emorell96/WaterSystemLock/RTD Measurement/Simulations by TI/Readme.txt

Resistance Temperature Detector RTD Linearization

RTD Linearization v7.xls
This Excel file calculates platinum RTD resistance and circuit values to linearize output voltage over a specified temperature range. Two solutions are shown—one using an op amp, the other using an instrumentation amplifier.

Entry values are highlighted in yellow. Results are in green.

Excel 2003 was used and the worksheet uses only basic math functions. The graph shows nonlinearity of the RTD and nonlinearity of the corrected voltage output, assuming perfect amplifiers and exact resistor values.

RTD Linearization, Op Amp circuit.TSC
Tina SPICE simulation file for the op amp-based RTD linearization circuit. This file can be run with the free version of Tina-TI, downloadable at www.ti.com/tina-ti.

RTD Linearization, Inst Amp circuit.TSC
Tina SPICE simulation file for the instrumentation amplifier-based linearization circuit. This file can be run with the free version of Tina-TI, downloadable at www.ti.com/tina-ti.

ALL CONTENT AND MATERIALS IN THESE FILES ARE PROVIDED "AS IS". TI AND ITS RESPECTIVE SUPPLIERS AND PROVIDERS OF CONTENT MAKE NO REPRESENTATIONS ABOUT THE SUITABILITY OF THESE MATERIALS FOR ANY PURPOSE AND DISCLAIM ALL WARRANTIES AND CONDITIONS WITH REGARD TO THESE MATERIALS, INCLUDING BUT NOT LIMITED TO ALL IMPLIED WARRANTIES AND CONDITIONS OF MERCHANTABILITY, FITNESS FOR A PARTICULAR PURPOSE, TITLE AND NON-INFRINGEMENT OF ANY THIRD PARTY INTELLECTUAL PROPERTY RIGHT. TI AND ITS RESPECTIVE SUPPLIERS AND PROVIDERS OF CONTENT MAKE NO REPRESENTATIONS ABOUT THE SUITABILITY OF THESE MATERIALS FOR ANY PURPOSE AND DISCLAIM ALL WARRANTIES AND CONDITIONS WITH RESPECT TO THESE MATERIALS. NO LICENSE, EITHER EXPRESS OR IMPLIED, BY ESTOPPEL OR OTHERWISE, IS GRANTED BY TI. USE OF THE INFORMATION ON THIS SITE MAY REQUIRE A LICENSE FROM A THIRD PARTY, OR A LICENSE FROM TI.
