emorell96/WaterSystemLock/UHV Gate Valve Control/Project Outputs for Free Documents/BOM/Bill of Materials-UHV Gate Valve Control.xlsx

Line # | Name | Description | Designator | Quantity | Adjusted Quantity | Manufacturer 1 | Manufacturer Part Number 1 | Manufacturer Lifecycle 1 | Supplier 1 | Supplier Part Number 1 | Supplier Unit Price 1 | Supplier Subtotal 1
 | 22uF | CAP ALUM 22UF 20% 100V RADIAL | C6 | 1 | 3 | Panasonic | EEUFC2A220 | Volume Production | Digi-Key | P10770-ND | 0.46 | 2.3
 | 0.1uF | CAP CER 0.1UF 25V X7R 0805 | C1, C2, C4, C11, C12, C13, C14, C15, C16, C17, C20 | 11 | 28 | Samsung | CL21B104KACNNNC | Volume Production | Digi-Key | 1276-1099-6-ND | 0.0203 | 2.03
 | 2.2uF | CAP CER 2.2UF 100V X7R 1206 | C9 | 1 | 3 | KEMET | C1206C225K3RACTU | Volume Production | Digi-Key | 399-8180-1-ND | 0.35 | 1.75
 | 4.7uF | CAP CER 4.7UF 10V X7R 1206 | C10 | 1 | 3 | Samsung | CL31B475KPHNNNE | Volume Production | Digi-Key | 1276-1133-1-ND | 0.28 | 1.4
 | 4.7uF | CAP CER 4.7UF 50V X5R 1206 | C7, C8 | 2 | 5 | TDK | C3216X5R1H475K085AB | Volume Production | Digi-Key | 445-14692-6-ND | 0.664 | 6.64
 | 10uF | CAP CER 10UF 25V X7R 1206 | C18, C19 | 2 | 5 | KEMET | C1206C106M3RACTU | Volume Production | Digi-Key | 399-7443-1-ND | 0.548 | 5.48
 | 22uF | CAP CER 22UF 25V X5R 1206 | C21, C22 | 2 | 5 | Samsung | CL31A226KAHNNNE | Volume Production | Digi-Key | 1276-3047-6-ND | 0.361 | 3.61
 | 10000pF | CAP CER 10000PF 25V X7R 0805 | C3, C5 | 2 | 5 | Samsung | CL21B103KAANNNC | Volume Production | Digi-Key | 1276-2434-6-ND | 0.054 | 0.54
 | 22272021 | CONN HEADER 2POS .100 VERT TIN | RLY_F | 1 | 3 | Molex | 22-27-2021 | Volume Production | Newark | 74C1122 | 0.122 | 0.61
 | 22272031 | CONN HEADER 3POS .100 VERT TIN | J2 | 1 | 3 | Molex | 22-27-2031 | Volume Production | Digi-Key | WM4112-ND | 0.37 | 1.85
 | 691508110303 | CONN TERM BLK 3POS 3.5MM BLACK | AC_POW_IN, AC_POW_OUT | 2 | 5 | Wurth Electronics | 691508110303 | Volume Production | Digi-Key | 732-5964-1-ND | 3.4 | 33.95
 | NXJ1S0505MC-R7 | DC/DC SM 1W 5V-5V SINGLE 4.2KV | A1 | 1 | 3 | Murata | NXJ1S0505MC-R7 | Volume Production | Digi-Key | 811-3094-6-ND | 3.53 | 17.65
 | SI8641BB-B-IS | DGTL ISO 2.5KV GEN PURP 16SOIC | IC2 | 1 | 3 | Silicon Labs | Si8641BB-B-IS | Volume Production | Digi-Key | SI8641BB-B-IS-ND | 1.84 | 9.2
 | ADA4075-2ARZ | Double Channel Ultra Low Noise Operational Amplifier, 6.5 MHz BW, 12 V/us SR, Industrial, 8-pin SOIC (R-8), Tube | U5 | 1 | 3 | Analog Devices | ADA4075-2ARZ | Volume Production | Digi-Key | ADA4075-2ARZ-ND | 2.27 | 11.35
 | 3.3uH | FIXED IND 3.3UH 9A 9 MOHM SMD | L3 | 1 | 3 | Wurth Electronics | 744314330 | Volume Production | Digi-Key | 732-1160-1-ND | 3.56 | 17.8
 | VLCF4024T-4R7N1R4-2 | FIXED IND 4.7UH 1.43A 87 MOHM | L1 | 1 | 3 | TDK EPCOS | VLCF4024T-4R7N1R4-2 | Volume Production | Digi-Key | 445-8737-1-ND | 0.97 | 4.85
 | VLCF4024T-100MR90-2 | FIXED IND 10UH 900MA 136 MOHM | L2 | 1 | 3 | TDK | VLCF4024T-100MR90-2 | Volume Production | Digi-Key | 445-8727-6-ND | 0.97 | 4.85
 | 3-1415055-1 | Force Guided Relay SR4 D/M, 24 V, 8 A, -25 to 70 degC, 10-Pin THD, RoHS, Box and Tube | K1 | 1 | 3 | TE Connectivity Schrack | 3-1415055-1 | Volume Production | Digi-Key | PB661-ND | 22.98 | 114.9
 | CD74HC21M96 | High Speed CMOS Logic Dual 4-Input AND Gates, D0014A, LARGE T&R | U3 | 1 | 3 | Texas Instruments | CD74HC21M96 | Volume Production | Digi-Key | 296-31574-6-ND | 0.54 | 2.7
 | TPS563201DDCT | IC REG BUCK ADJ 3A SYNC | IC4 | 1 | 3 | Texas Instruments | TPS563201DDCT | Volume Production | Digi-Key | 296-43393-6-ND | 0.93 | 4.65
 | BSS138WH6327XTSA1 | MOSFET N-CH 60V 280MA SOT-323 | IC1, IC3 | 2 | 5 | Infineon | BSS138W | Unknown | Digi-Key | BSS138WH6327XTSA1DKR-ND | 0.25 | 2.5
 | NE555D | Precision Timer, 4.5 to 16 V, 0 to 70 degC, 8-Pin SOIC (D), Green (RoHS & no Sb/Br), Tube | U2 | 1 | 3 | Texas Instruments | NE555D | Volume Production | Digi-Key | 296-16792-ND | 0.41 | 2.05
 | 1k | RES SMD 1K OHM 1% 1/4W 1206 | R1 | 1 | 3 | Panasonic | ERJ-8ENF1001V | Volume Production | Digi-Key | P1.00KFCT-ND | 0.1 | 0.5
 | 10k | RES SMD 10K OHM 1% 1/2W 0805 | R12, R13 | 2 | 5 | Panasonic | ERJ-P06F1002V | Volume Production | Digi-Key | P16059DKR-ND | 0.148 | 1.48
 | 10k | RES SMD 10K OHM 1% 1/4W 1206 | R4, R5, R6, R8, R15 | 5 | 13 | Panasonic | ERJ-8ENF1002V | Volume Production | Digi-Key | P10.0KFCT-ND | 0.089 | 2.23
 | 54.9k | RES SMD 54.9K OHM 0.5% 1/2W 0805 | R11 | 1 | 3 | Panasonic | ERJ-P06D5492V | Volume Production | Digi-Key | P16052DKR-ND | 0.31 | 1.55
 | 510k | RES SMD 510K OHM 5% 1/4W 1206 | R3 | 1 | 3 | Panasonic | ERJ-8GEYJ514V | Volume Production | Digi-Key | P510KEDKR-ND | 0.1 | 0.5
 | 620 | RES SMD 620 OHM 1% 1/4W 1206 | R7, R9, R10, R14 | 4 | 10 | Panasonic | ERJ-8ENF6200V | Volume Production | Digi-Key | P620FDKR-ND | 0.089 | 1.78
 | SN74LVC1G86DBVR | Single 2-Input Exclusive-OR Gate, DBV0005A, LARGE T&R | U4 | 1 | 3 | Texas Instruments | SN74LVC1G86DBVR | Volume Production | Digi-Key | 296-9853-1-ND | 0.33 | 1.65
 | LM311DR2G | Single Comparator, 5 to 30 V, 0 to 70 degC, 8-Pin SOIC, Pb-Free, Tape and Reel | U1 | 1 | 3 | ON Semiconductor | LM311DR2G | Volume Production | Digi-Key | LM311DR2GOSDKR-ND | 0.43 | 2.15
 | AB11AH-HC | SWITCH PUSH SPST-NO 0.4VA 28V | RST | 1 | 3 | NKK Switches | AB11AH-HC | Volume Production | Digi-Key | 360-2604-ND | 5.5 | 27.5
 | CL-SB-12B-01T | SWITCH SLIDE SPDT 200MA 12V | BYP, INT_SWITCH, ON, SW5V | 4 | 10 | Nidec Copal | CL-SB-12B-01T | Volume Production | Digi-Key | 563-1318-1-ND | 0.924 | 18.48
 | 282834-2 | TERM BLOCK 2POS SIDE ENT 2.54MM | EXT_SWITCH, J1, POW5, POW12 | 4 | 10 | TE Connectivity | 282834-2 | Volume Production | Digi-Key | A98333-ND | 0.626 | 12.52
 | 20k | TRIMMER 20K OHM 3/8" CERMET TH | R2 | 1 | 3 | TT BI | 91AR20KLF | Volume Production | Digi-Key | 987-1170-ND | 1.5 | 7.5
 | SM15T15CA | TVS DIODE 12.8VWM 27.2VC SMC | D1 | 1 | 3 | STMicroelectronics | SM15T15CA | Volume Production | Digi-Key | 497-7863-1-ND | 0.87 | 4.35
 | LED2 | Typical RED GaAs LED | FAIL | 1 | 3
 | LED1 | Typical RED GaAs LED | RLOK1, RLOK2 | 2 | 5
 | 696105003002 | WR-FSH Fuse Holder Blocks Fuse Holder Blocks Clip Cover for PCB | XF1 | 1 | 3 | Wurth Electronics | 696105003002 | Unknown | Digi-Key | 732-11373-ND | 0.64 | 3.2
