emorell96/WaterSystemLock/RTD Measurement/Project Outputs for Free Documents/BOM/Bill of Materials-RTDMeasurement.xls

Line # | Name | Description | Designator | Quantity | Manufacturer 1 | Manufacturer Part Number 1 | Manufacturer Lifecycle 1 | Supplier 1 | Supplier Part Number 1 | Supplier Unit Price 1 | Supplier Subtotal 1
 | NXJ1S0505MC-R7 | DC/DC SM 1W 5V-5V SINGLE 4.2KV | A1 | 1 | Murata | NXJ1S0505MC-R7 | Volume Production | Digi-Key | 811-3094-1-ND | 3.55 | 3.55
 | 0.10uF | CAP CER 0.1UF 16V X7R 0402 | C1A, C1B, C1C, C1D, C1E, C1F, C1G, C1H, C1I, C1J, C1K, C1L, C2A, C2B, C2C, C2D, C2E, C2F, C2G, C2H, C2I, C2J, C2K, C2L, C6A, C6B, C6C, C6D, C6E, C6F, C6G, C6H, C6I, C6J, C6K, C6L, C15A, C15B, C15C, C16A, C16B, C16C, C17A, C17B, C17C, C18A, C18B, C18C, C19A, C19B, C19C, C20A, C20B, C20C, C37 | 55 | Murata | GRM155R71C104JA88D | Volume Production | Mouser | 81-GRM155R71C104JA8D | 0.018 | 1.8
 | 1uF | CAP CER 1UF 25V X7R 0805 | C3A, C3B, C3C, C4A, C4B, C4C, C5A, C5B, C5C | 9 | KEMET | C0805C105J3RACTU | Volume Production | Digi-Key | 399-10060-2-ND | 0.32905 | 822.63
 | 22uF | CAP ALUM 22UF 20% 100V RADIAL | C7, C21, C29 | 3 | Panasonic | EEUFC2A220 | Volume Production | Digi-Key | P10770-ND | 0.46 | 1.38
 | 4.7uF | CAP CER 4.7UF 50V X5R 1206 | C8, C9, C22, C23, C30, C31 | 6 | TDK | C3216X5R1H475K085AB | Volume Production | Digi-Key | 445-14692-2-ND | 0.231 | 924
 | 22uF | CAP CER 22UF 25V X5R 1210 | C10, C11, C12, C13, C25, C26, C27, C28, C33, C34, C35, C36 | 12 | Murata | GRM32ER61E226KE15K | Volume Production | Digi-Key | 490-6540-2-ND | 0.6537 | 2614.8
 | 0.022uF | CAP CER 0.022UF 100V X7R 0805 | C14 | 1 | KEMET | C0805S223K1RACTU | Volume Production | Digi-Key | 399-13176-2-ND | 0.10061 | 402.44
 | 2.2uF | CAP CER 2.2UF 100V X7R 1206 | C24, C32, C43 | 3 | Samsung | CL31B225KCHSNNE | Volume Production | Digi-Key | 1276-3138-2-ND | 0.22539 | 450.78
 | 10uF | CAP CER 10UF 25V X7R 1206 | C38, C39 | 2 | KEMET | C1206C106M3RACTU | Volume Production | Digi-Key | 399-7443-2-ND | 0.19808 | 396.16
 | 0.1uF | CAP CER 0.1UF 25V X7R 0805 | C40 | 1 | KEMET | C0805C104J3RACTU | Volume Production | Digi-Key | 399-7997-2-ND | 0.1485 | 594
 | 22uF | CAP CER 22UF 10V X7R 1206 | C41, C42 | 2 | KEMET | C1206C226M8RACTU | Volume Production | Digi-Key | 399-7444-2-ND | 0.17055 | 341.1
 | 4.7uF | CAP CER 4.7UF 10V X7R 1206 | C44 | 1 | Samsung | CL31B475KPHNNNE | Volume Production | Digi-Key | 1276-1133-2-ND | 0.0506 | 101.2
 | 22272081 | CONN HEADER 8POS .100 VERT TIN | CF1A, CF1B, CF1C, CF2A, CF2B, CF2C, J2, J3 | 8 | Molex | 22272081 | Unknown | Digi-Key | WM4117-ND | 0.6 | 4.8
 | SI8640BD-B-IS | DGTL ISO 5KV 4CH GEN PURP 16SOIC | IC1A, IC1B, IC1C, IC2A, IC2B, IC2C, IC3A, IC3B, IC3C | 9 | Silicon Labs | SI8640BD-B-IS | Volume Production | Digi-Key | 336-2083-5-ND | 3.59 | 32.31
 | BSS138WH6327XTSA1 | MOSFET N-CH 60V 280MA SOT-323 | IC4 | 1 | Infineon | BSS138WH6327XTSA1 | Volume Production | Digi-Key | BSS138WH6327XTSA1DKR-ND | 0.35 | 0.35
 | TPS563201DDCT | IC REG BUCK ADJ 3A SYNC | IC5 | 1 | Texas Instruments | TPS563201DDCT | Volume Production | Digi-Key | 296-43393-2-ND | 0.60844 | 152.11
 | SJ-3506-SMT-TR | Female Mid Mount Audio Jack, 6 Position, Height 2.55 mm, Tail Length 2 mm, -25 to 85 degC, RoHS, Tape and Reel | J1A, J1B, J1C, J1D, J1E, J1F, J1G, J1H, J1I, J1J, J1K, J1L | 12 | CUI | SJ-3506-SMT-TR | Volume Production | Digi-Key | CP-3506SJCT-ND | 1.65 | 19.82
 | SDS-50J | CONN RCPT FMALE DIN 5POS SOLDER | J4 | 1 | CUI | SDS-50J | Volume Production | Digi-Key | CP-2350-ND | 1.86 | 1.86
 | PJ-063AH | Through Hole Right Angle DC Power Jack, 8 A, 2 mm Center Pin, 2 Position, -25 to 85 degC, RoHS, Bulk | J5 | 1 | CUI | PJ-063AH | Volume Production | Digi-Key | CP-063AH-ND | 1.36 | 1.36
 | 3.3uH | FIXED IND 3.3UH 9A 9 MOHM SMD | L1 | 1 | Wurth Electronics | 744314330 | Volume Production | Digi-Key | 732-1160-2-ND | 2.55 | 2554.01
 | VLCF4024T-4R7N1R4-2 | FIXED IND 4.7UH 1.43A 87 MOHM | L2 | 1 | TDK EPCOS | VLCF4024T-4R7N1R4-2 | Volume Production | Digi-Key | 445-8737-2-ND | 0.441 | 220.5
 | VLCF4024T-100MR90-2 | FIXED IND 10UH 900MA 136 MOHM | L3 | 1 | TDK | VLCF4024T-100MR90-2 | Volume Production | Digi-Key | 445-8727-2-ND | 0.441 | 220.5
 | CL-SB-12B-01T | SWITCH SLIDE SPDT 200MA 12V | ON/OFF1, ON/OFF_+5 | 2 | Nidec Copal | CL-SB-12B-01T | Volume Production | Digi-Key | 563-1318-1-ND | 0.9 | 1.8
 | 691321100003 | Serie 3211 - 3.50mm Vertical PCB Header WR-TBL, 3 pin | POW_1, POW_2 | 2 | Wurth Electronics | 691321100003 | Volume Production | Digi-Key | 732-2764-ND | 0.69 | 1.38
 | 4.99k | RES SMD 4.99K OHM 0.1% 1/8W 0805 | R1A, R1B, R1C, R1D, R1E, R1F, R1G, R1H, R1I, R1J, R1K, R1L, R2A, R2B, R2C, R2D, R2E, R2F, R2G, R2H, R2I, R2J, R2K, R2L | 24 | Panasonic | ERA-6AEB4991V | Volume Production | Digi-Key | P4.99KDATR-ND | 0.03749 | 187.45
 | 118 | RES SMD 118 OHM 0.1% 1/8W 0805 | R3A, R3B, R3C, R3D, R3E, R3F, R3G, R3H, R3I, R3J, R3K, R3L | 12 | Panasonic | ERA-6AEB1180V | Unknown | Digi-Key | P118DATR-ND | 0.04158 | 207.9
 | 107 | RES SMD 107 OHM 0.1% 1/8W 0805 | R4A, R4B, R4C, R4D, R4E, R4F, R4G, R4H, R4I, R4J, R4K, R4L | 12 | Panasonic | ERA6AEB1070V | Not Recommended for New Design | Digi-Key | P107DACT-ND | 0.302 | 3.62
 | 10.2k | RES SMD 10.2K OHM 0.1% 1/8W 0805 | R5A, R5B, R5C, R5D, R5E, R5F, R5G, R5H, R5I, R5J, R5K, R5L | 12 | Panasonic | ERA6AEB1022V | Not Recommended for New Design | Digi-Key | P10.2KDADKR-ND | 0.302 | 3.62
 | 15.8k | RES SMD 15.8K OHM 1% 1/8W 0805 | R6A, R6B, R6C, R6D, R6E, R6F, R6G, R6H, R6I, R6J, R6K, R6L, R7A, R7B, R7C, R7D, R7E, R7F, R7G, R7H, R7I, R7J, R7K, R7L, R14, R15 | 26 | Panasonic | ERJ-6ENF1582V | Volume Production | Digi-Key | P15.8KCTR-ND | 0.00961 | 48.05
 | 1k | RES SMD 1K OHM 1% 1/4W 1206 | R8A, R8B, R8C, R8D, R8E, R8F, R8G, R8H, R8I, R8J, R8K, R8L | 12 | Panasonic | ERJ-8ENF1001V | Volume Production | Digi-Key | P1.00KFTR-ND | 0.01191 | 59.55
 | 20k | TRIMMER 20K OHM 3/8" CERMET TH | R9A, R9B, R9C, R9D, R9E, R9F, R9G, R9H, R9I, R9J, R9K, R9L | 12 | TT BI | 91AR20KLF | Volume Production | Digi-Key | 987-1170-ND | 1.32 | 15.84
 | 510k | RES SMD 510K OHM 5% 1/4W 1206 | R10A, R10B, R10C, R10D, R10E, R10F, R10G, R10H, R10I, R10J, R10K, R10L | 12 | Panasonic | ERJ-8GEYJ514V | Volume Production | Digi-Key | P510KETR-ND | 0.0088 | 44
 | 0 | RES SMD 0.0 OHM JUMPER 1/4W 1206 | R11, R20, R24 | 3 | Panasonic | ERJ8GEY0R00V | Volume Production | Digi-Key | P0.0ETR-ND | 0.00857 | 42.85
 | 174k | RES SMD 174K OHM 1% 1/8W 0805 | R12, R17, R21 | 3 | Panasonic | ERJ-6ENF1743V | Volume Production | Digi-Key | P174KCTR-ND | 0.00961 | 48.05
 | 267k | RES SMD 267K OHM 1% 1/4W 1206 | R13 | 1 | Panasonic | ERJ-8ENF2673V | Volume Production | Digi-Key | P267KFTR-ND | 0.01191 | 59.55
 | 140k | RES SMD 140K OHM 1% 1/8W 0805 | R16, R23 | 2 | Panasonic | ERJ-6ENF1403V | Volume Production | Digi-Key | P140KCTR-ND | 0.00961 | 48.05
 | 24.3k | RES SMD 24.3K OHM 1% 1/8W 0805 | R18, R22 | 2 | Panasonic | ERJ-6ENF2432V | Volume Production | Digi-Key | P24.3KCTR-ND | 0.00961 | 48.05
 | 52.3k | RES SMD 52.3K OHM 1% 1/8W 0805 | R19 | 1 | Panasonic | ERJ-6ENF5232V | Volume Production | Digi-Key | P52.3KCTR-ND | 0.00961 | 48.05
 | 54.9k | RES SMD 54.9K OHM 0.5% 1/2W 0805 | R25 | 1 | Panasonic | ERJ-P06D5492V | Volume Production | Digi-Key | P16052TR-ND | 0.03661 | 183.05
 | 10k | RES SMD 10K OHM 1% 1/2W 0805 | R26 | 1 | Panasonic | ERJ-P06F1002V | Volume Production | Digi-Key | P16059TR-ND | 0.02068 | 103.4
 | INA826AIDGKR | Precision, 200-uA Supply Current, 36-V Supply Instrumentation Amplifier, -40 to 125 degC, 8-pin SOP (DGK8), Green (RoHS & no Sb/Br) | U1A, U1B, U1C, U1D, U1E, U1F, U1G, U1H, U1I, U1J, U1K, U1L | 12 | Texas Instruments | INA826AIDGKR | Volume Production | Digi-Key | 296-29663-1-ND | 2.52 | 30.26
 | REF5050IDGKT | Low Noise, Very Low Drift, Precision Voltage Reference, -40 to 125 degC, 8-pin VSSOP (DGK), Green (RoHS & no Sb/Br) | U2A, U2B, U2C | 3 | Texas Instruments | REF5050IDGKT | Volume Production | Digi-Key | 296-24507-1-ND | 6.8 | 20.4
 | LM311DR2G | Single Comparator, 5 to 30 V, 0 to 70 degC, 8-Pin SOIC, Pb-Free, Tape and Reel | U3A, U3B, U3C, U3D, U3E, U3F, U3G, U3H, U3I, U3J, U3K, U3L | 12 | ON Semiconductor | LM311DR2G | Volume Production | Digi-Key | LM311DR2GOSDKR-ND | 0.382 | 4.58
 | LMZ34003 | DC DC CONVERTER 2.5-15V 38W | U4 | 1 | Texas Instruments | LMZ35003RKGR | Volume Production | Digi-Key | 296-43647-1-ND | 11.89 | 11.89
 | LMZ34002RKGT | No Description Available | U5, U7 | 2 | Texas Instruments | LMZ34002RKGT | Volume Production | Digi-Key | 296-37033-6-ND | 11.61 | 23.22
 | DCX144EH-7 | TRANS PREBIAS NPN/PNP SOT563 | U6, U8 | 2 | Diodes | DCX144EH-7 | Volume Production | Digi-Key | DCX144EH-7DICT-ND | 0.42 | 0.84
