emorell96/WaterSystemLock/RTD Measurement/RTDMeasurement.pdf

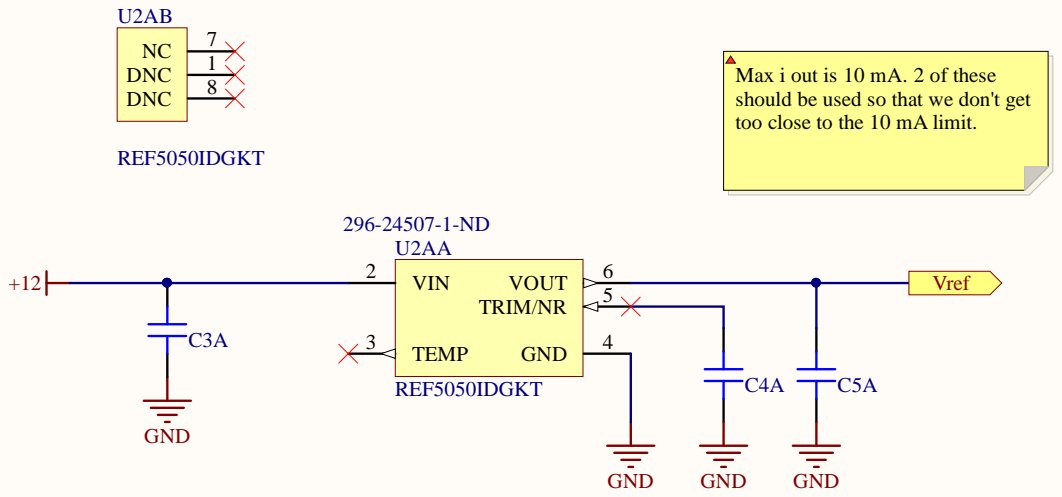
[picture p1: page 1]

Max i out is 10 mA. 2 of these
should be used so that we don't get
too close to the 10 mA limit.

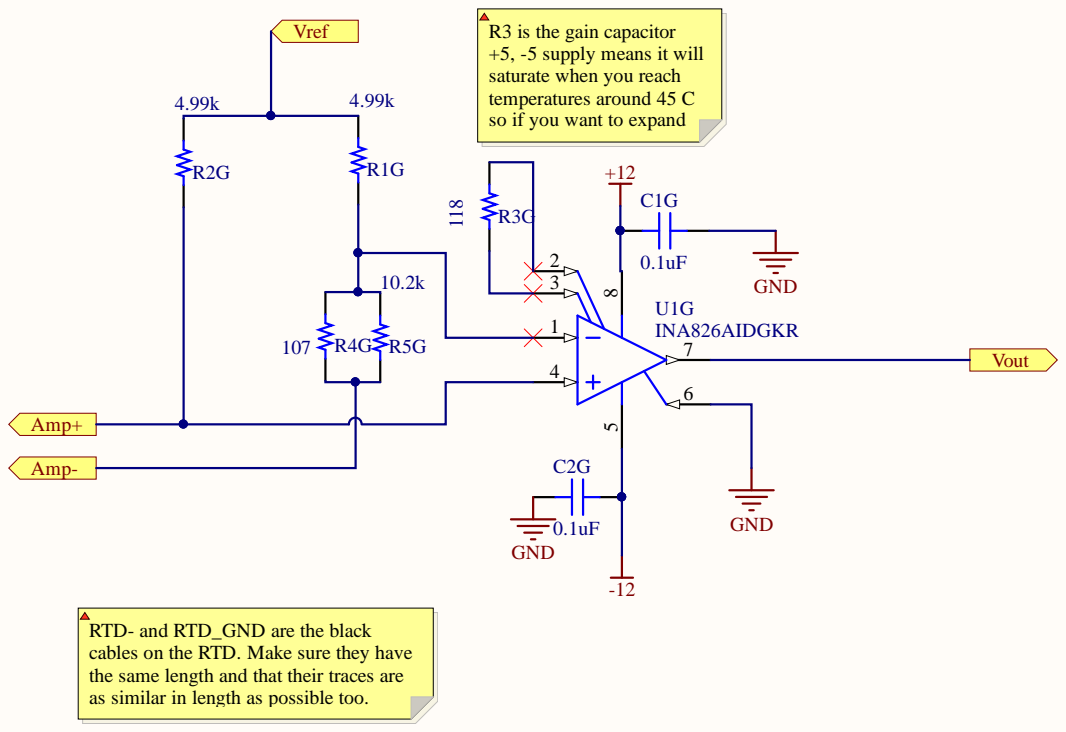
[picture p2: page 2]

R3 is the gain capacitor
+5, -5 supply means it will
saturate when you reach
temperatures around 45 C
so if you want to expand

RTD- and RTD_GND are the black
cables on the RTD. Make sure they have
the same length and that their traces are
as similar in length as possible too.

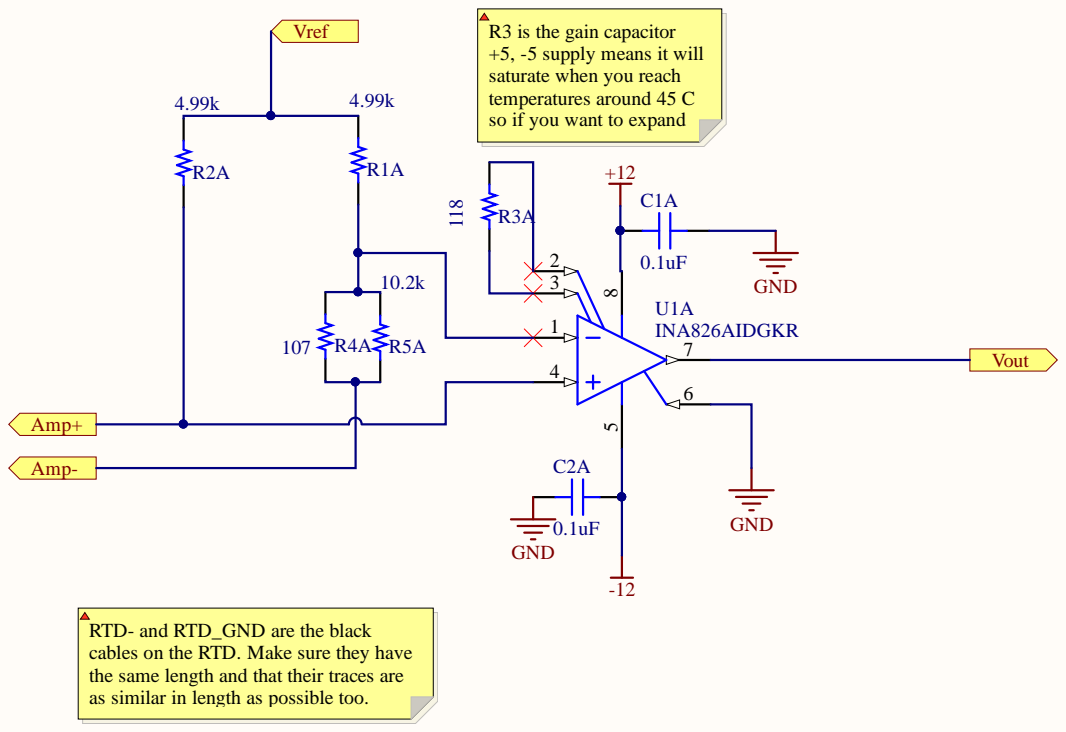
[picture p3: page 3]

R3 is the gain capacitor
+5, -5 supply means it will
saturate when you reach
temperatures around 45 C
so if you want to expand

RTD- and RTD_GND are the black
cables on the RTD. Make sure they have
the same length and that their traces are
as similar in length as possible too.

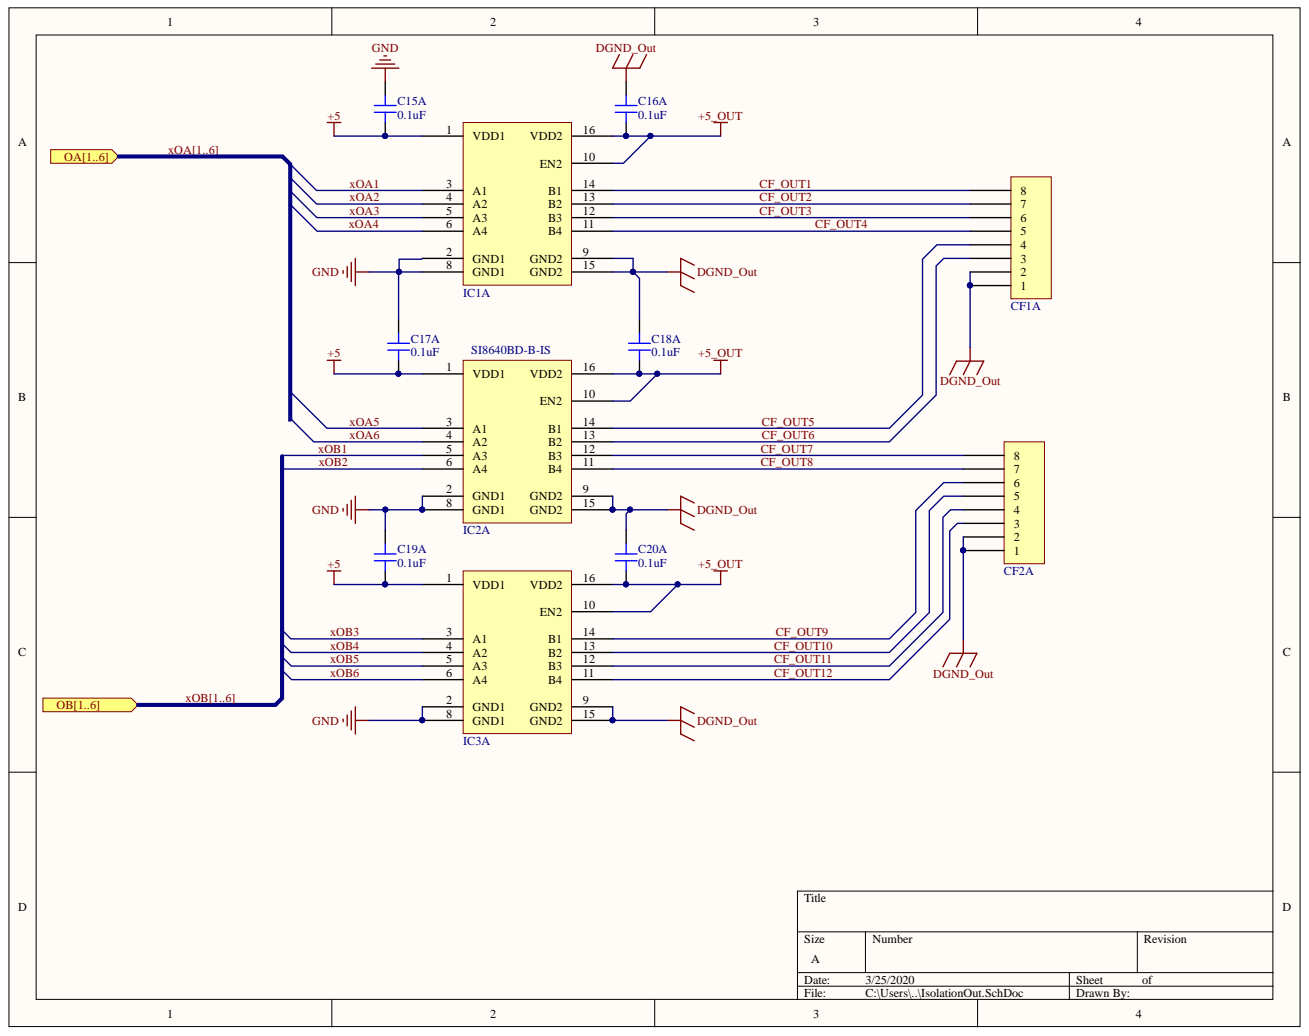
[picture p4: page 4]

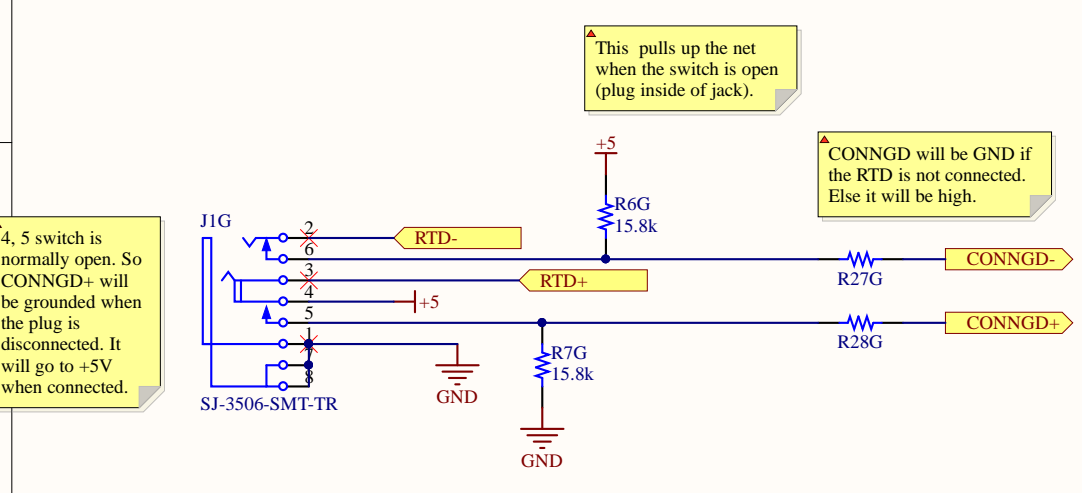
[picture p5: page 5]

This pulls up the net
when the switch is open
(plug inside of jack).

CONNGD will be GND if
the RTD is not connected.
Else it will be high.

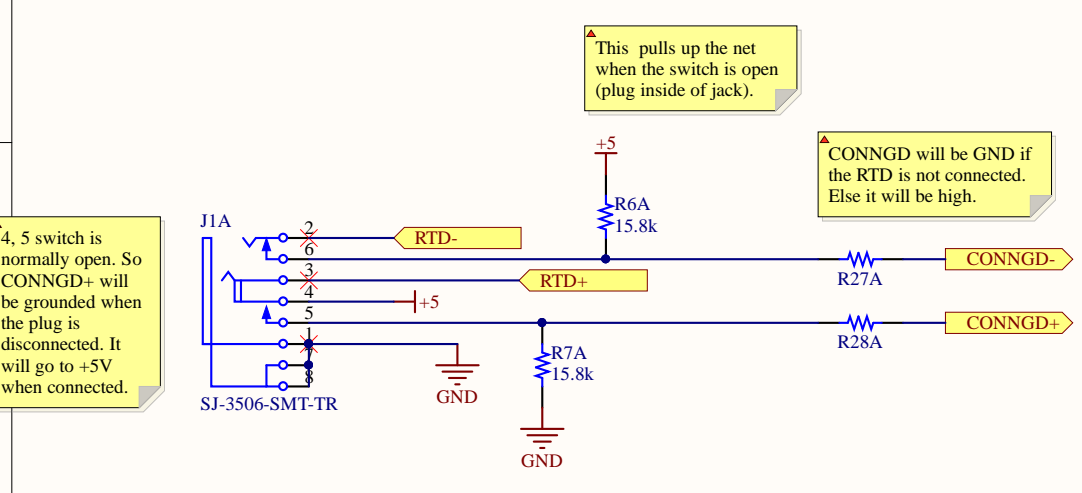
[picture p6: page 6]

This pulls up the net
when the switch is open
(plug inside of jack).

CONNGD will be GND if
the RTD is not connected.
Else it will be high.

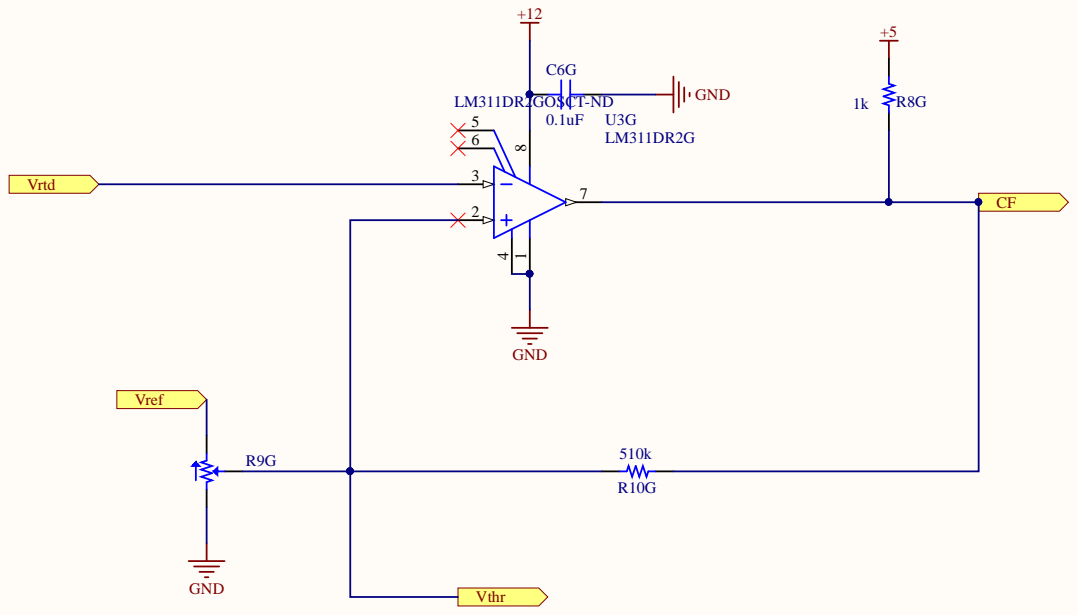
[picture p7: page 7]

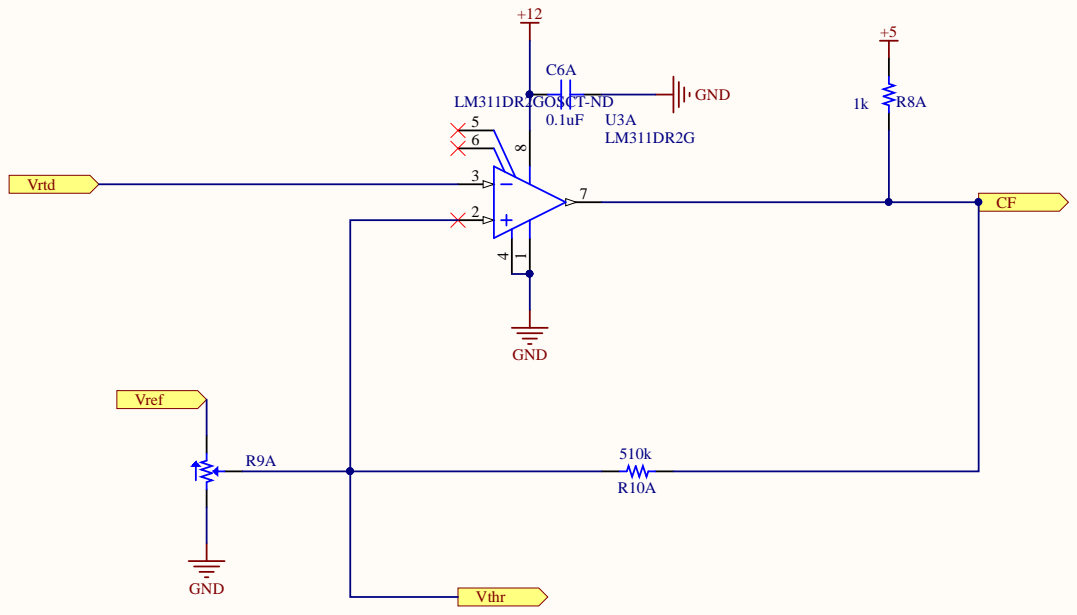
[picture p8: page 8]

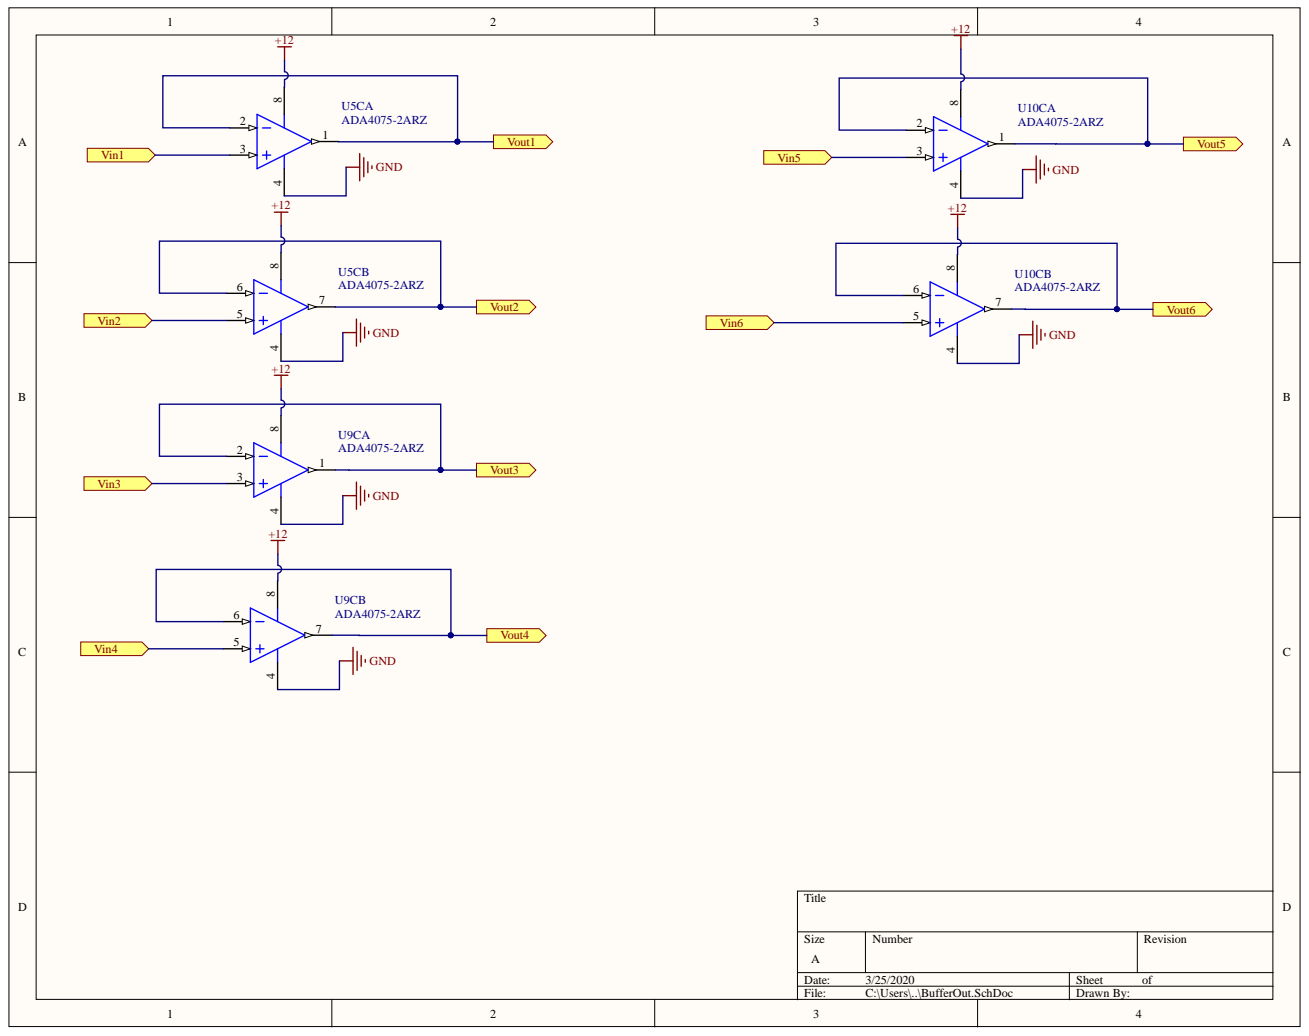
[picture p9: page 9]

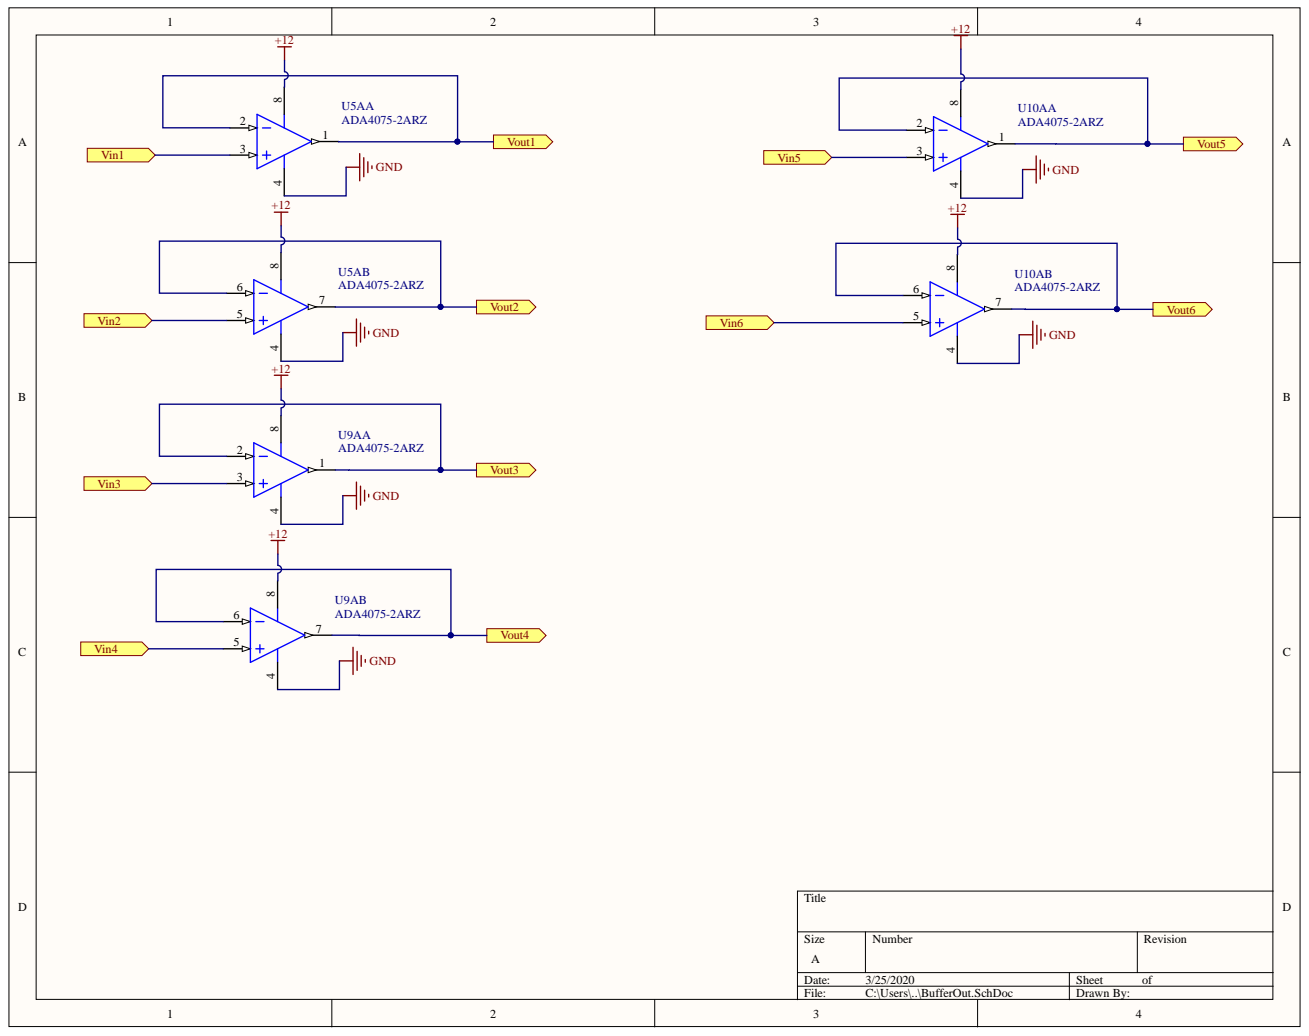
[picture p10: page 10]

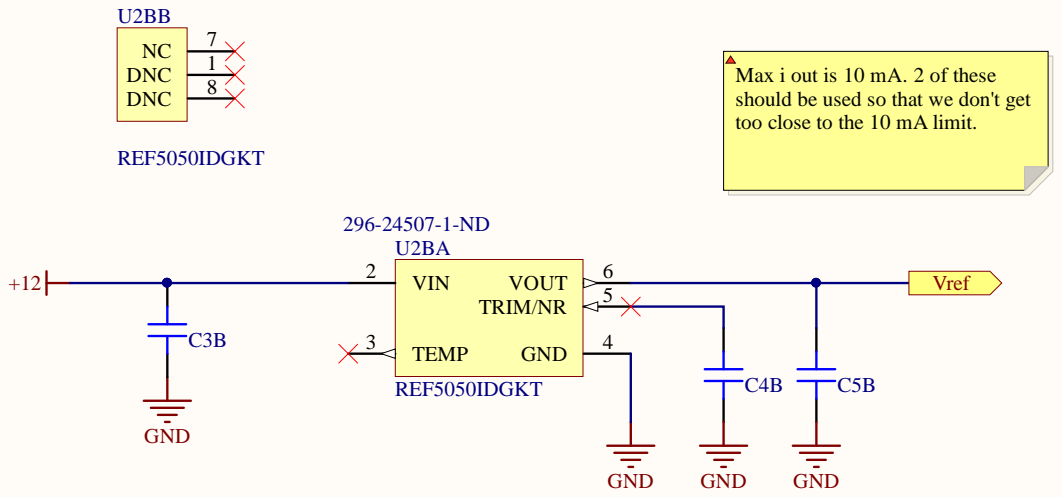
[picture p11: page 11]

Max i out is 10 mA. 2 of these
should be used so that we don't get
too close to the 10 mA limit.

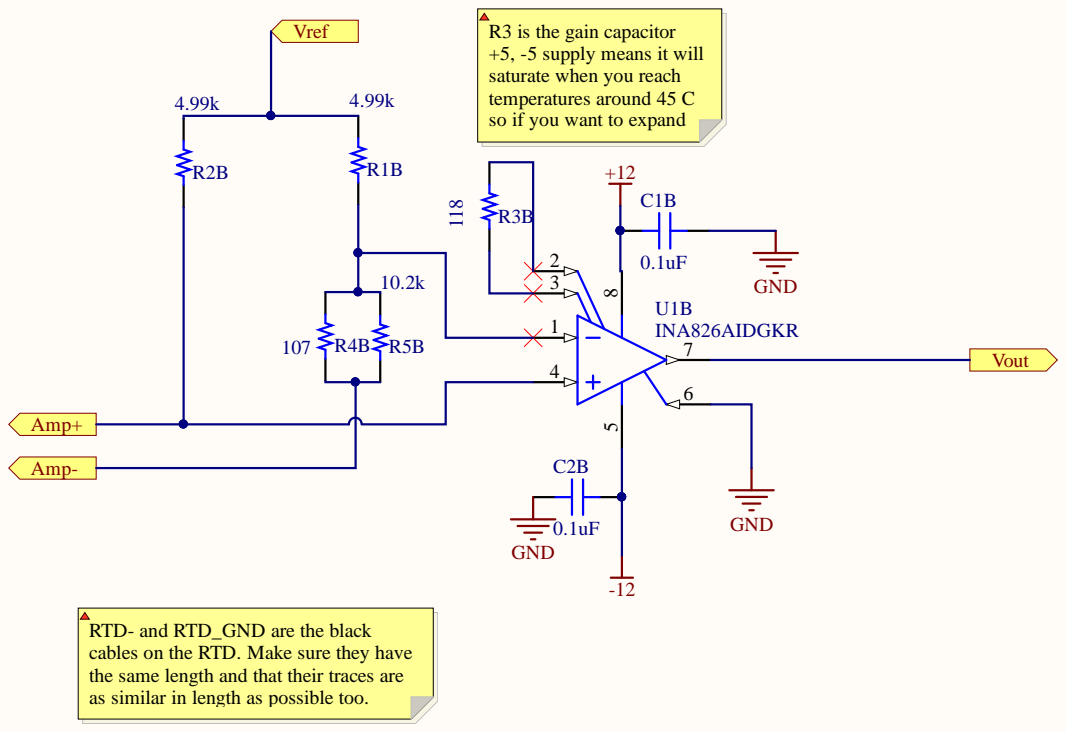
[picture p12: page 12]

R3 is the gain capacitor
+5, -5 supply means it will
saturate when you reach
temperatures around 45 C
so if you want to expand

RTD- and RTD_GND are the black
cables on the RTD. Make sure they have
the same length and that their traces are
as similar in length as possible too.

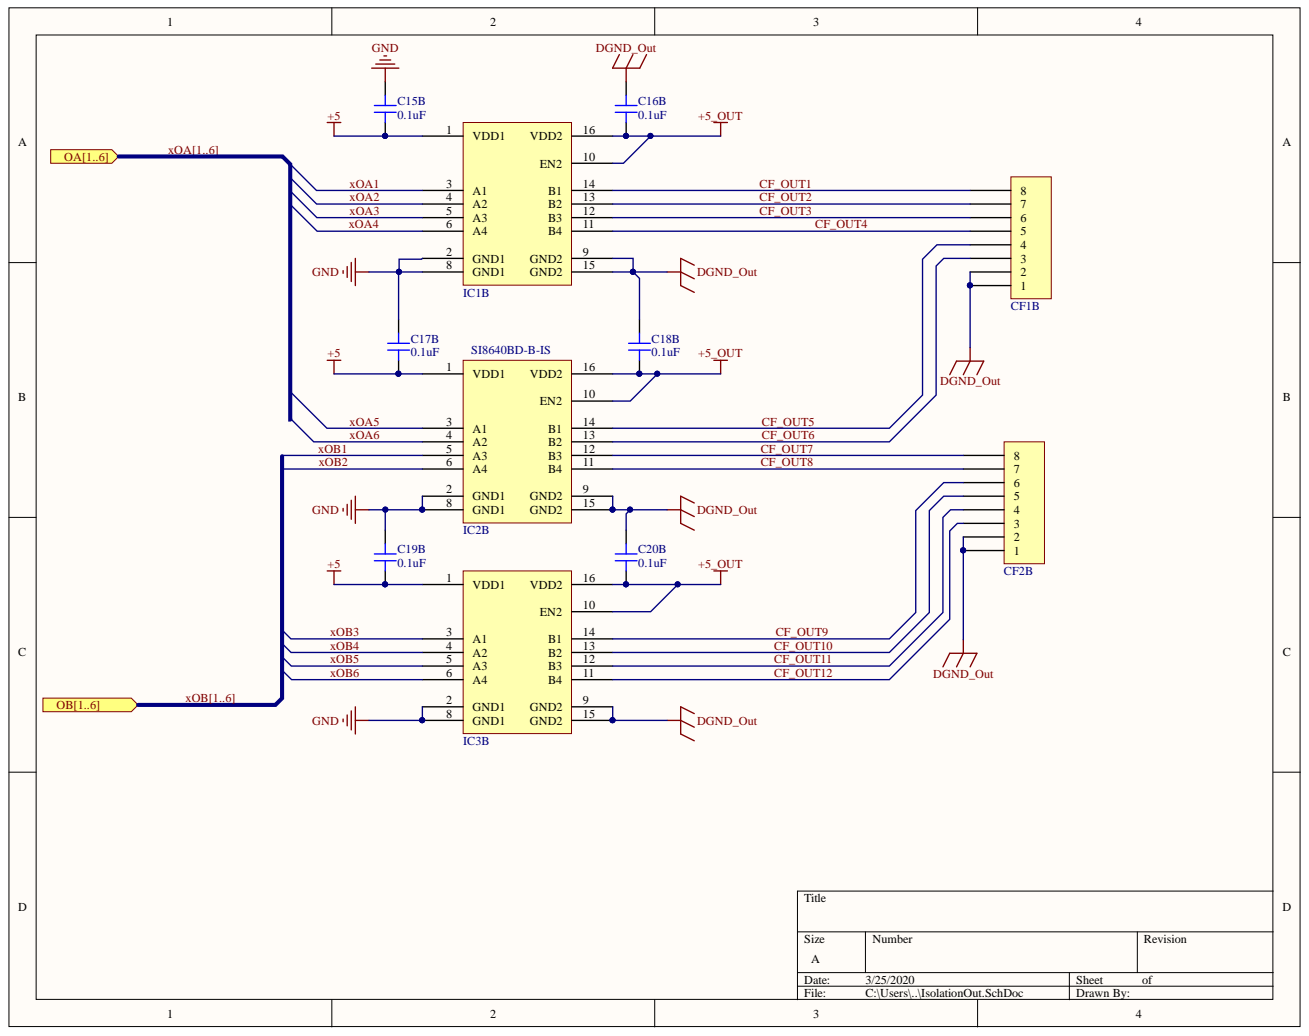
[picture p13: page 13]

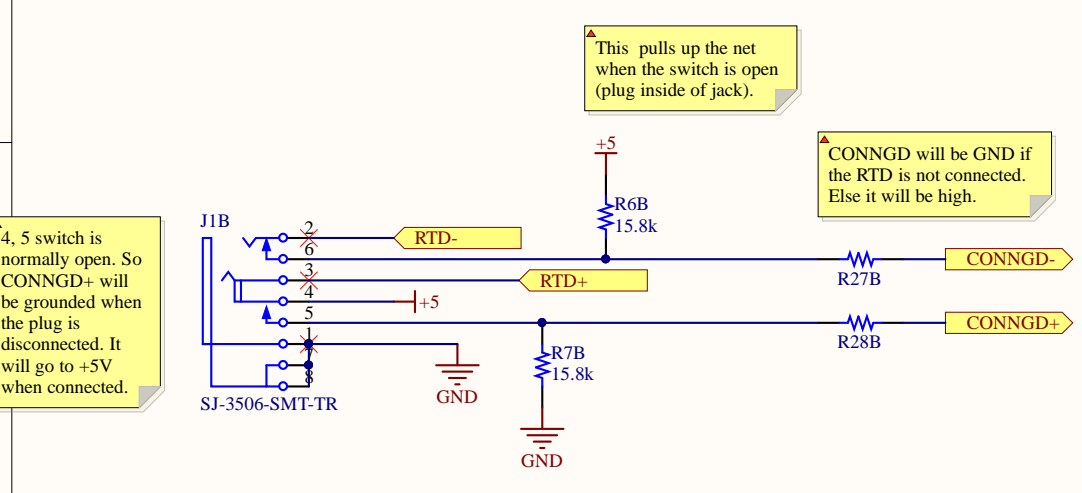
[picture p14: page 14]

This pulls up the net
when the switch is open
(plug inside of jack).

CONNGD will be GND if
the RTD is not connected.
Else it will be high.

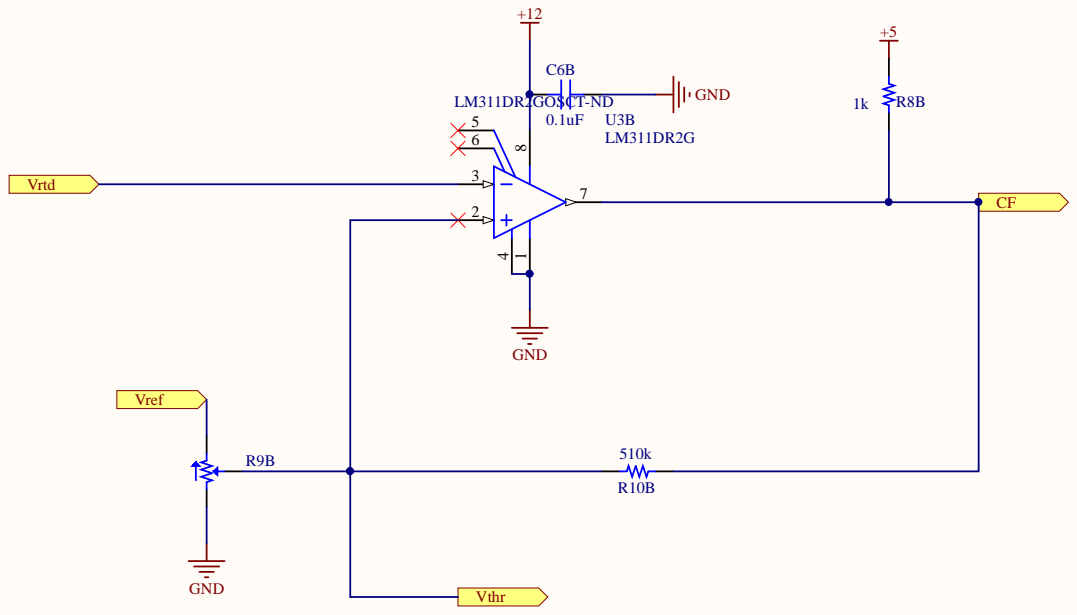
[picture p15: page 15]

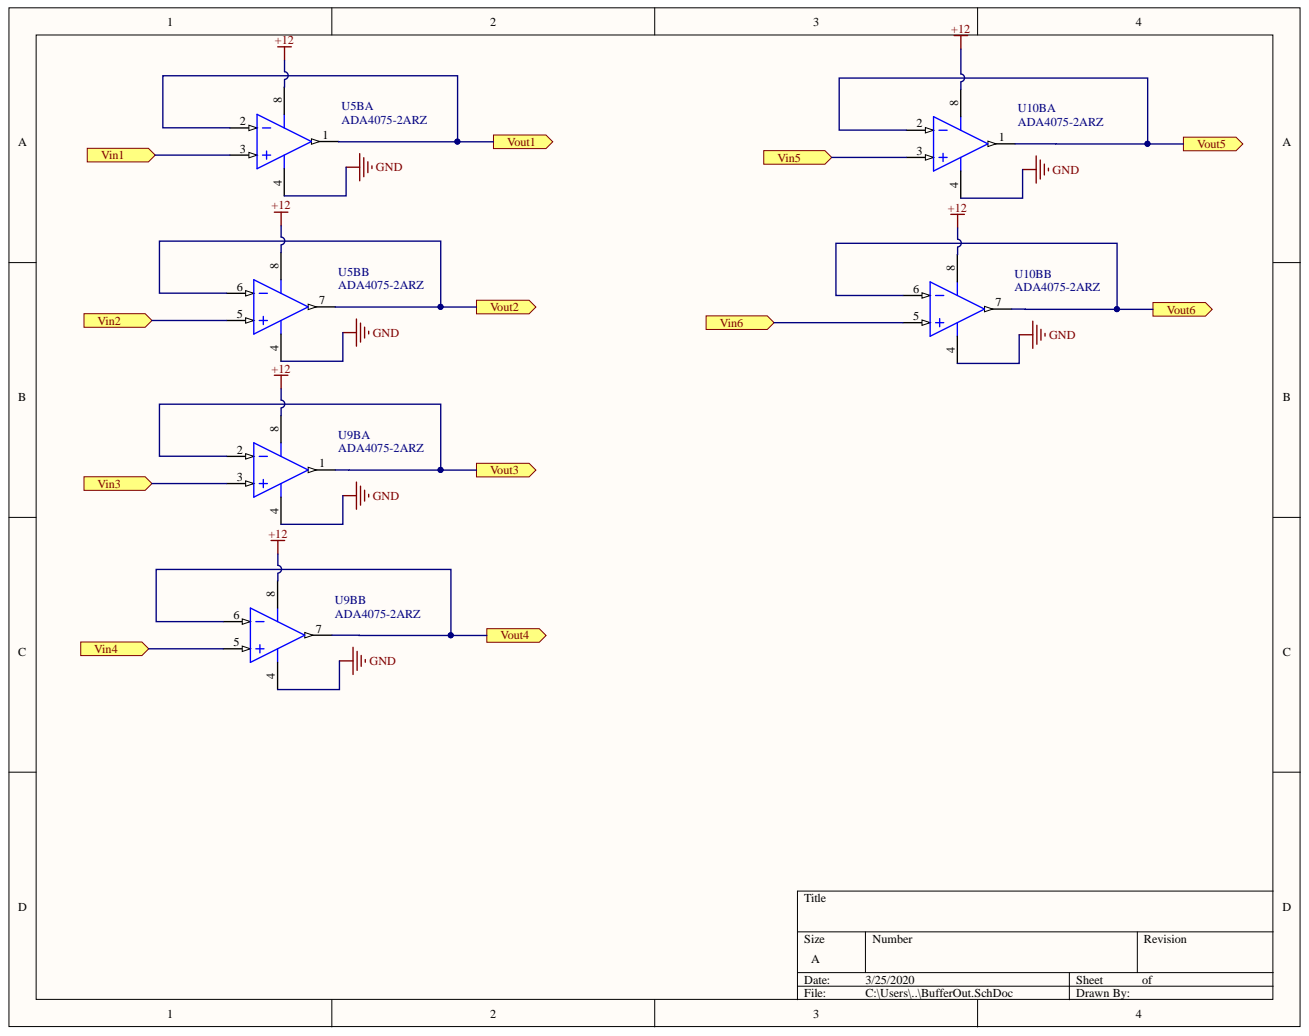
[picture p16: page 16]

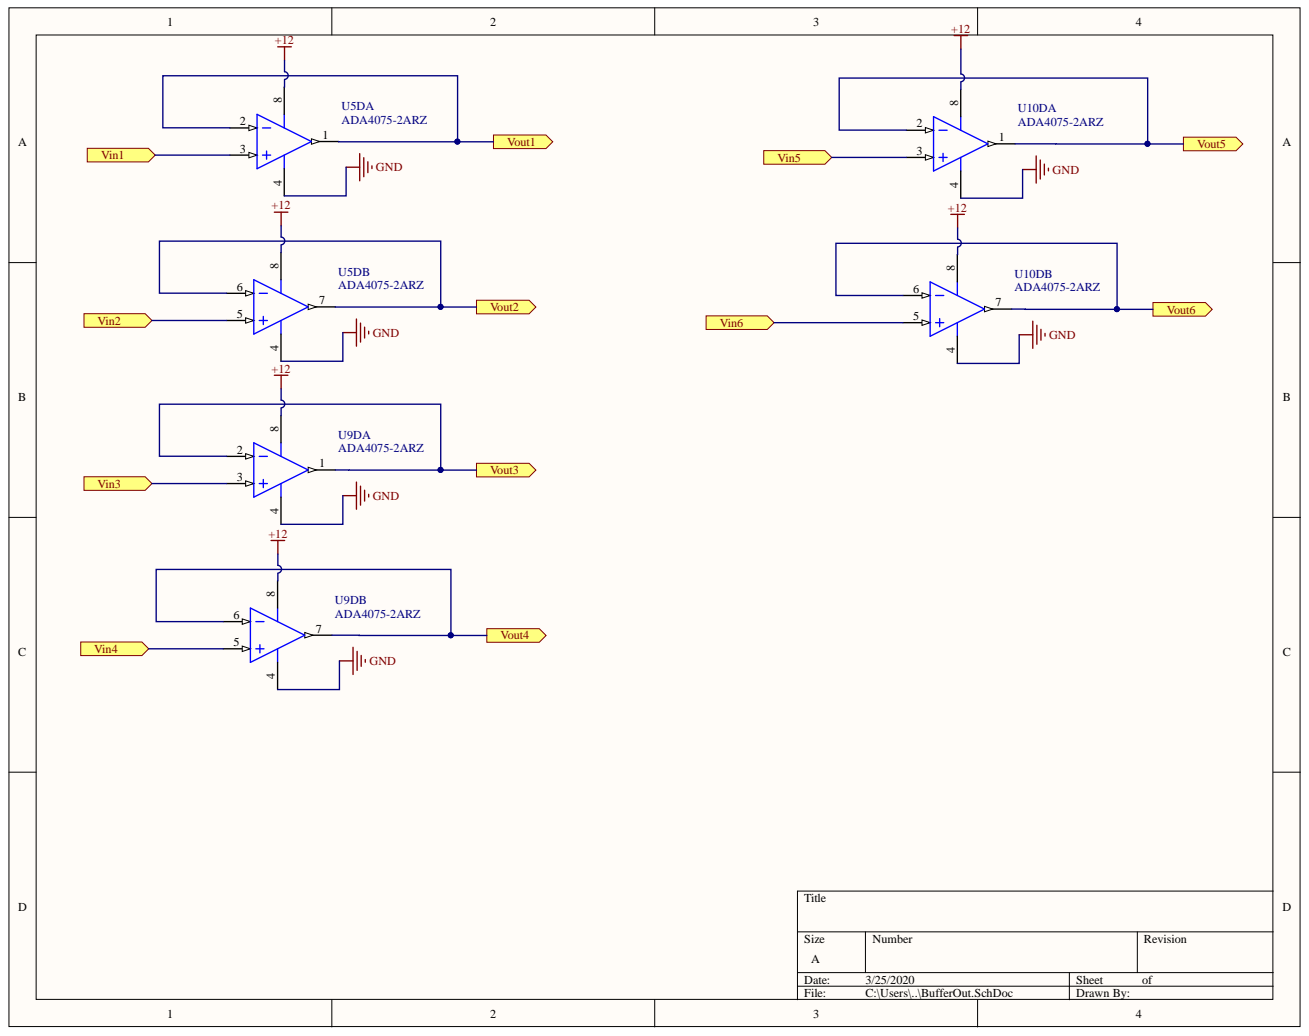
[picture p17: page 17]

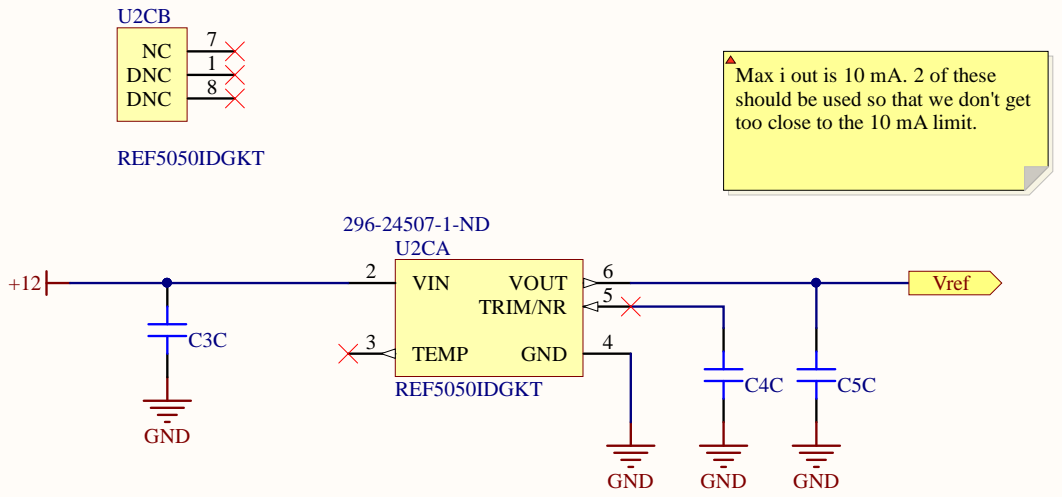
[picture p18: page 18]

Max i out is 10 mA. 2 of these
should be used so that we don't get
too close to the 10 mA limit.

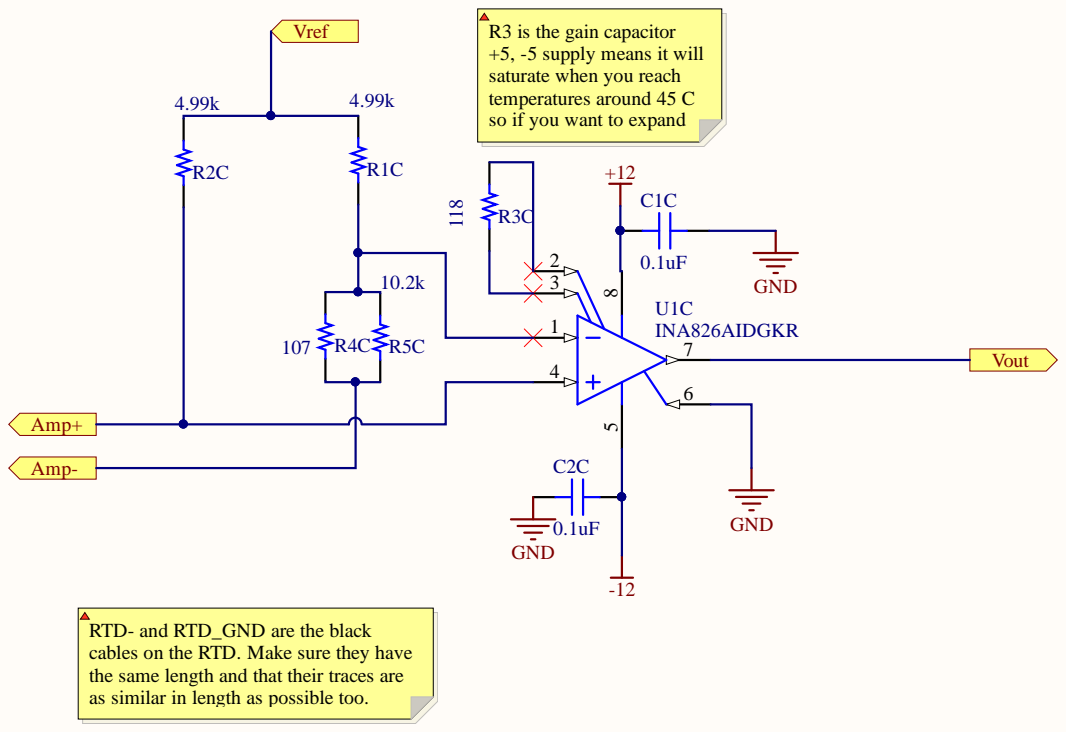
[picture p19: page 19]
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

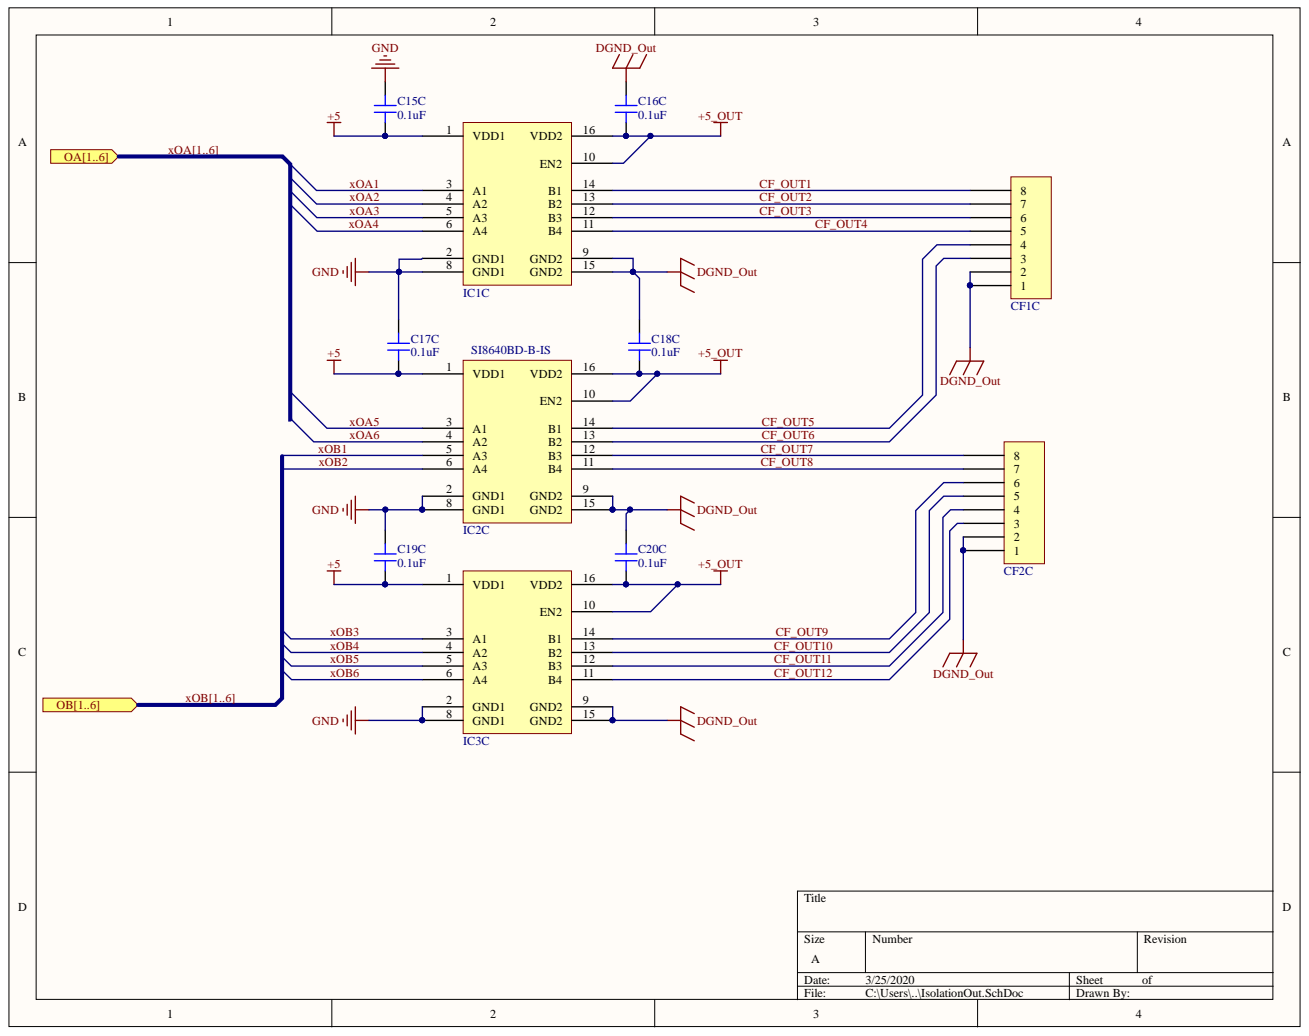
[picture p20: page 20]

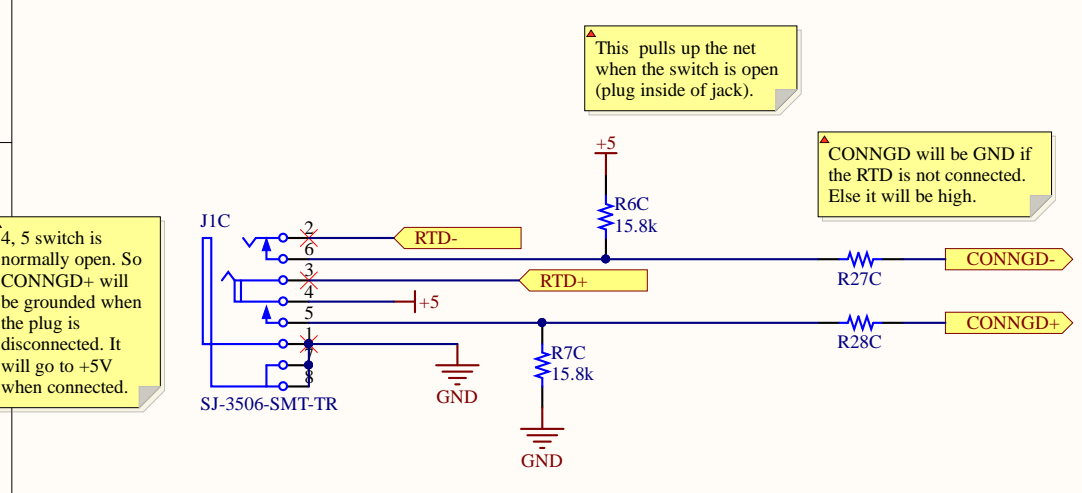
[picture p21: page 21]

This pulls up the net
when the switch is open
(plug inside of jack).

CONNGD will be GND if
the RTD is not connected.
Else it will be high.

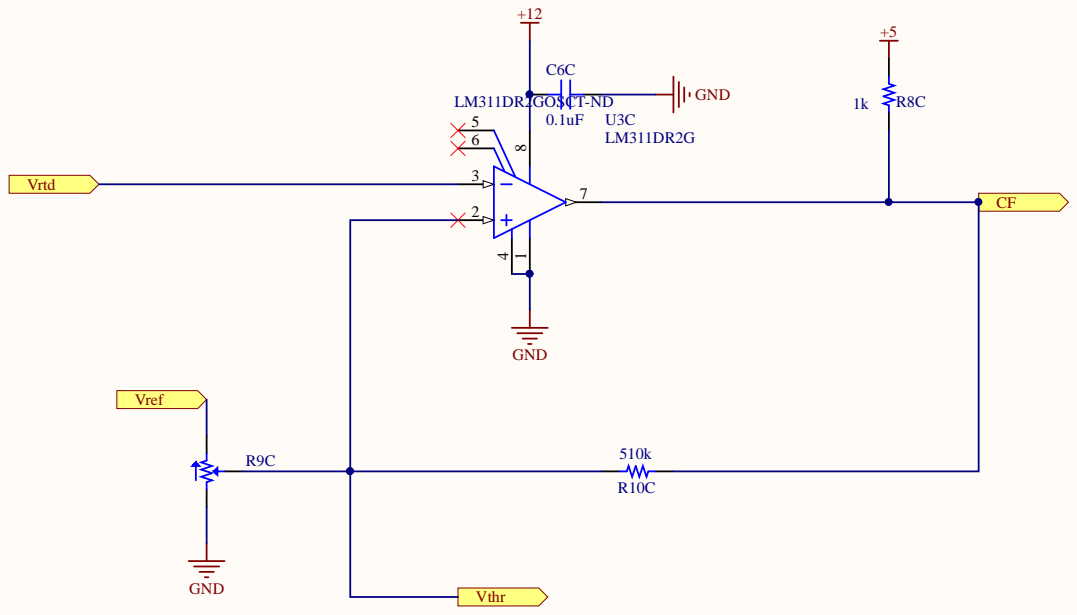
[picture p22: page 22]

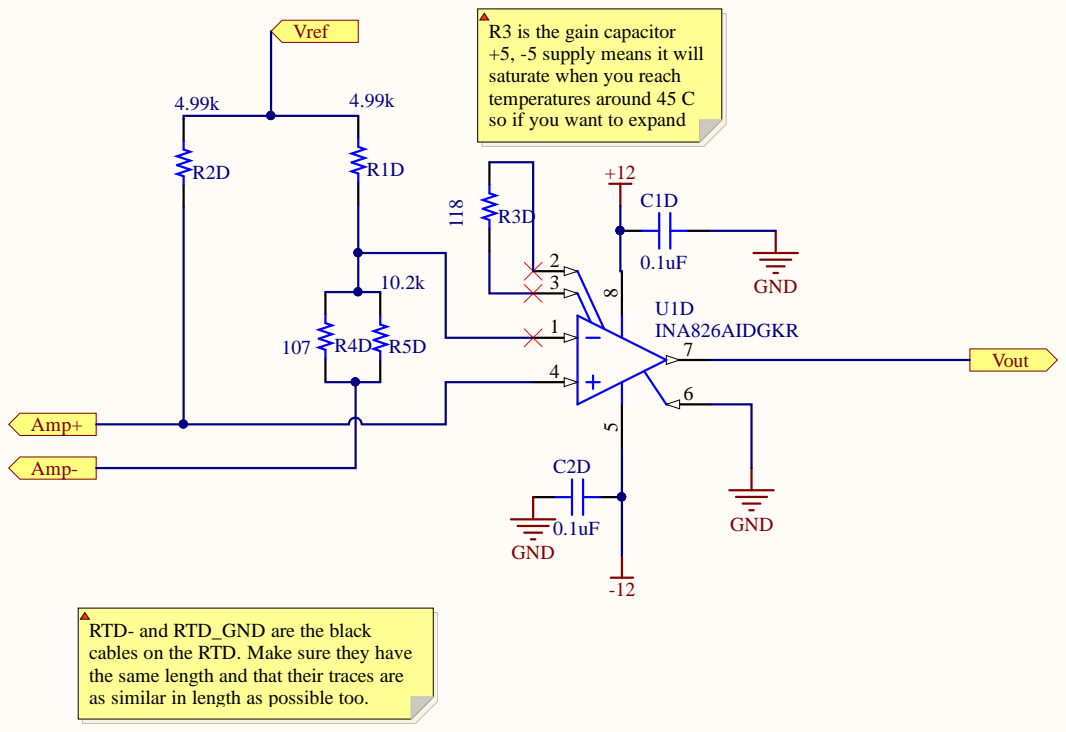
[picture p23: page 23]
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

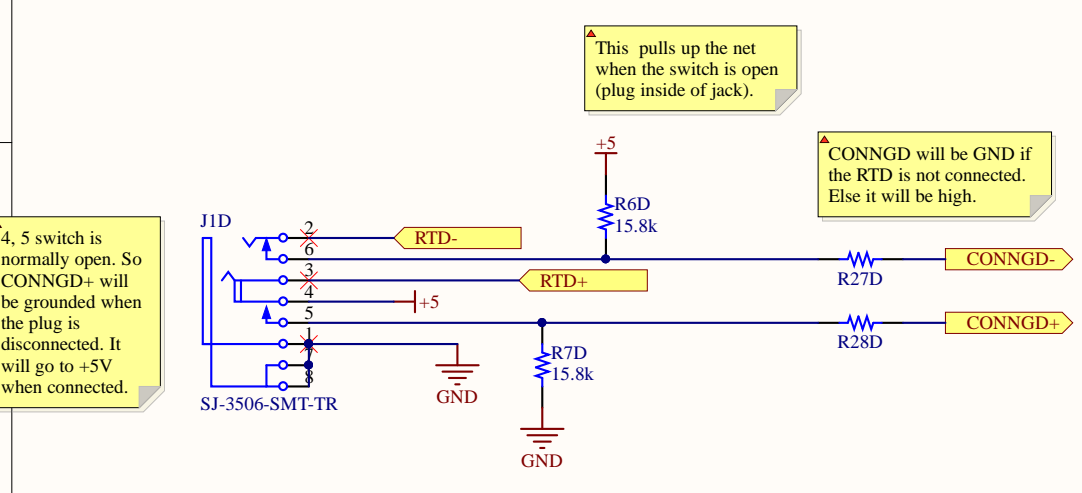
[picture p24: page 24]

This pulls up the net
when the switch is open
(plug inside of jack).

CONNGD will be GND if
the RTD is not connected.
Else it will be high.

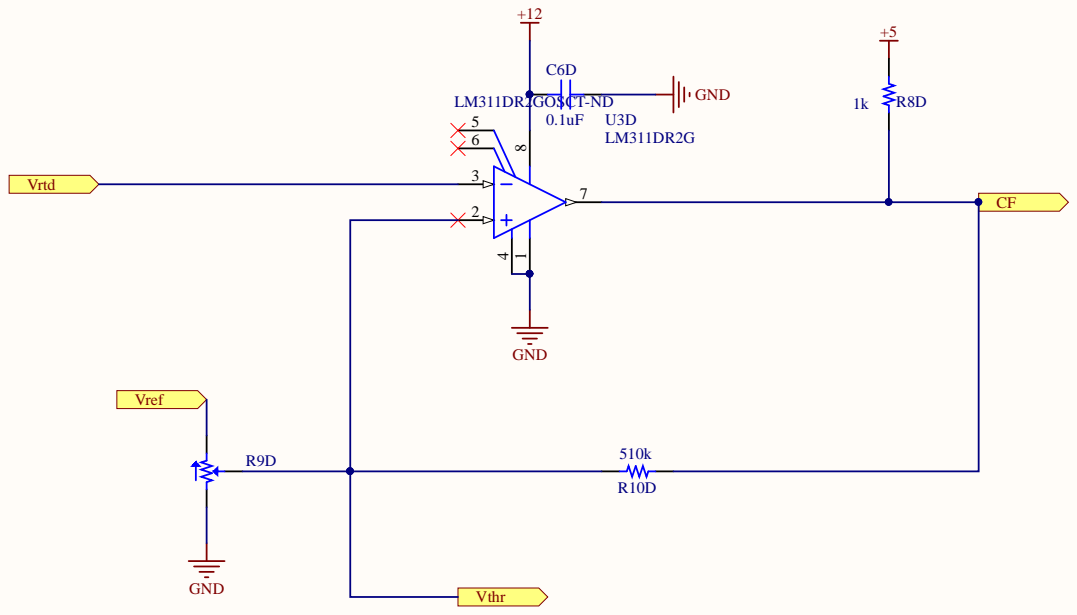
[picture p25: page 25]

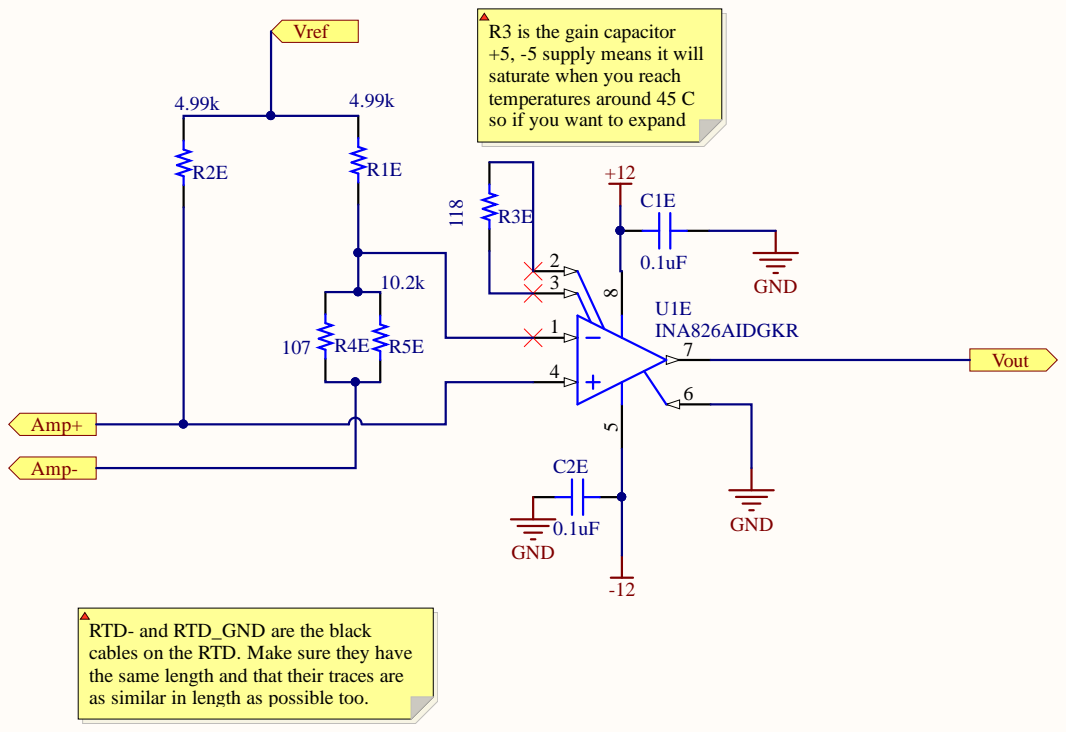
[picture p26: page 26]
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

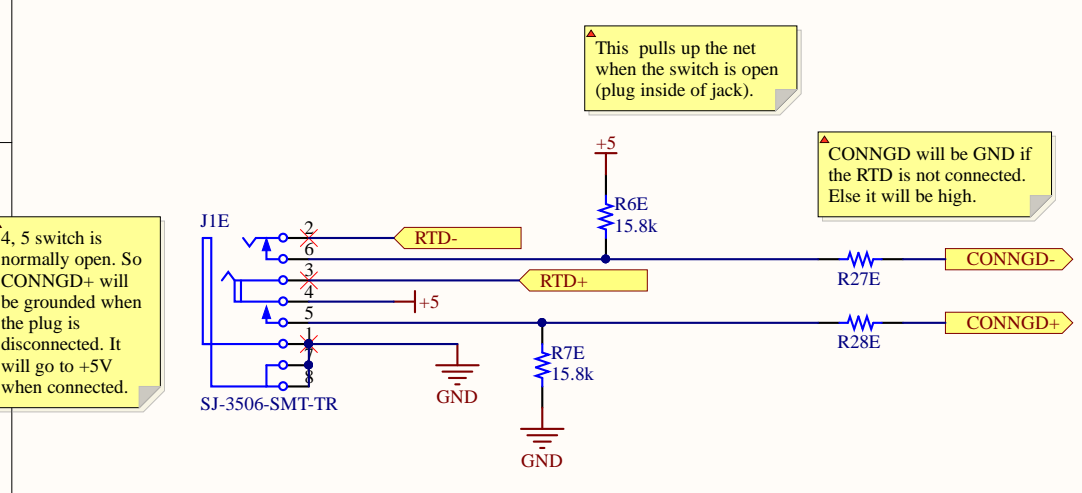
[picture p27: page 27]

This pulls up the net
when the switch is open
(plug inside of jack).

CONNGD will be GND if
the RTD is not connected.
Else it will be high.

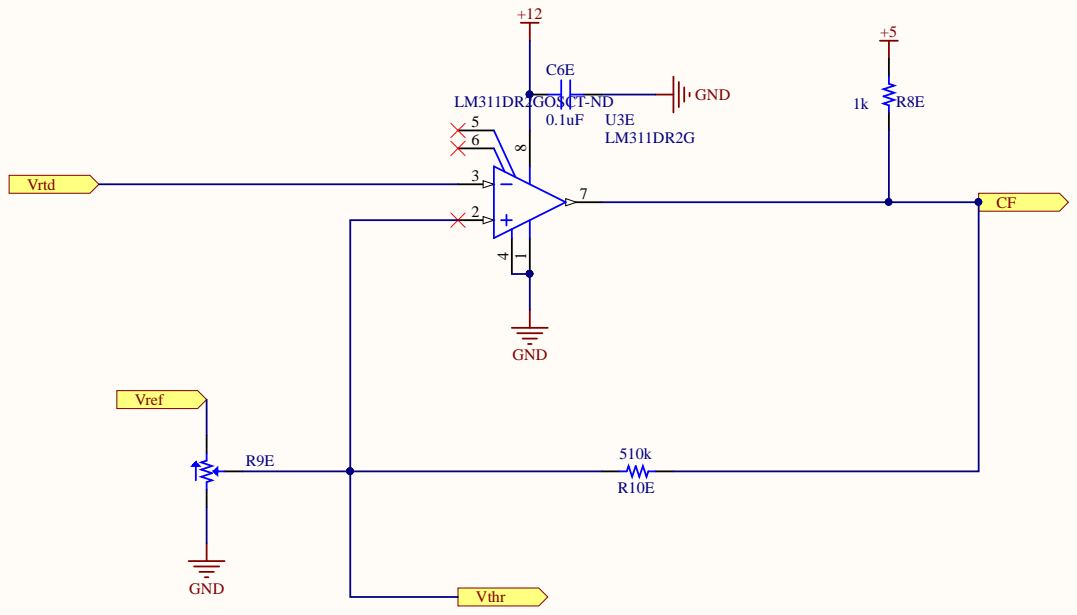
[picture p28: page 28]

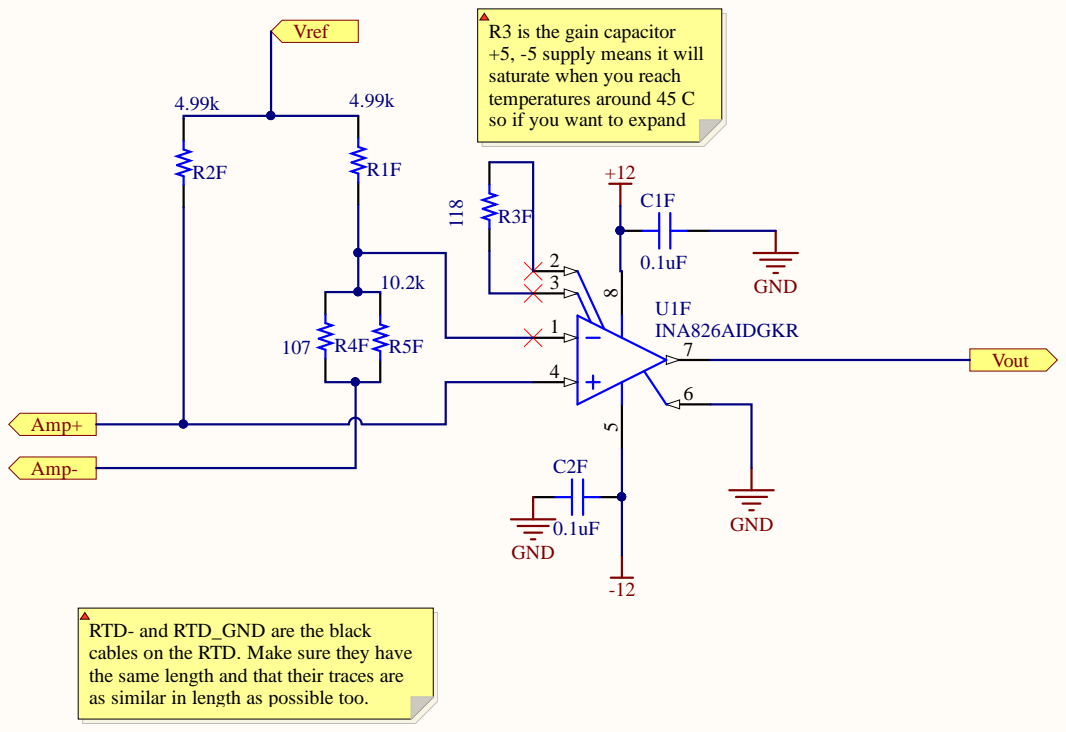
[picture p29: page 29]
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

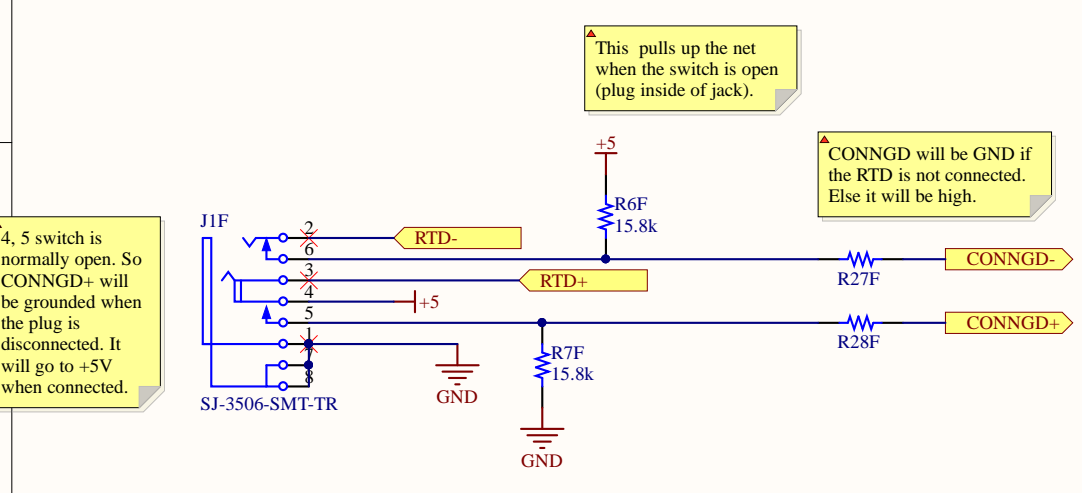
[picture p30: page 30]

This pulls up the net
when the switch is open
(plug inside of jack).

CONNGD will be GND if
the RTD is not connected.
Else it will be high.

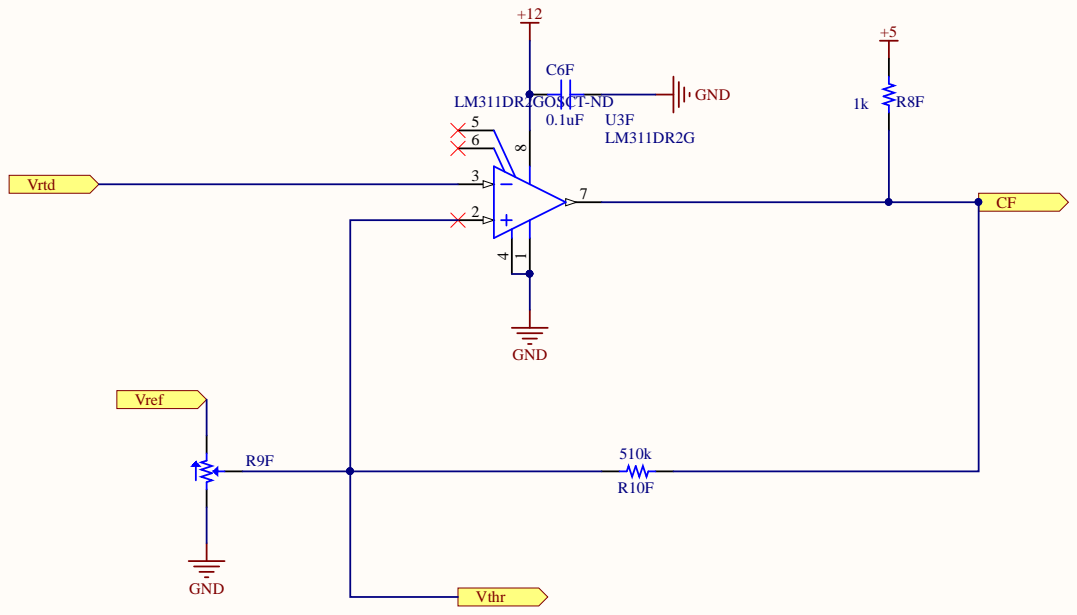
[picture p31: page 31]

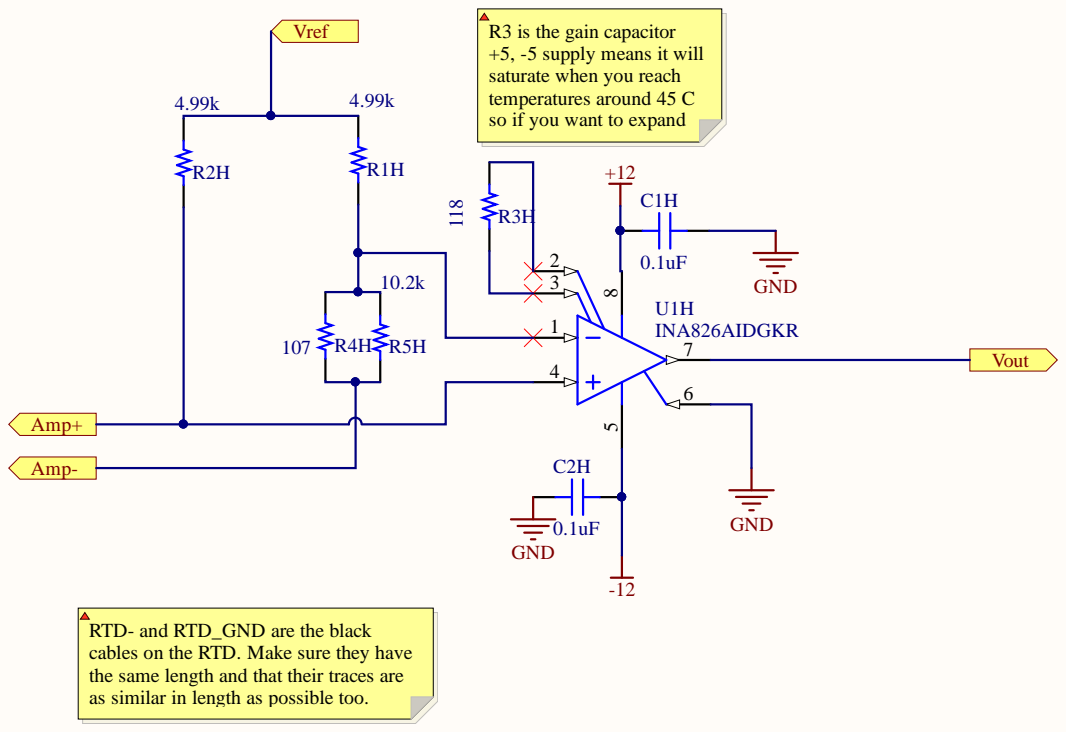
[picture p32: page 32]
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

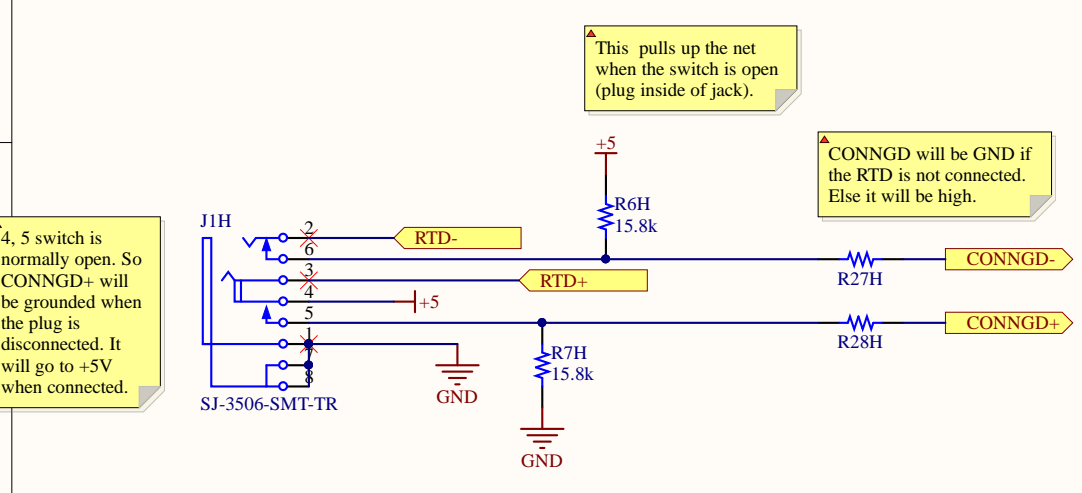
[picture p33: page 33]

This pulls up the net
when the switch is open
(plug inside of jack).

CONNGD will be GND if
the RTD is not connected.
Else it will be high.

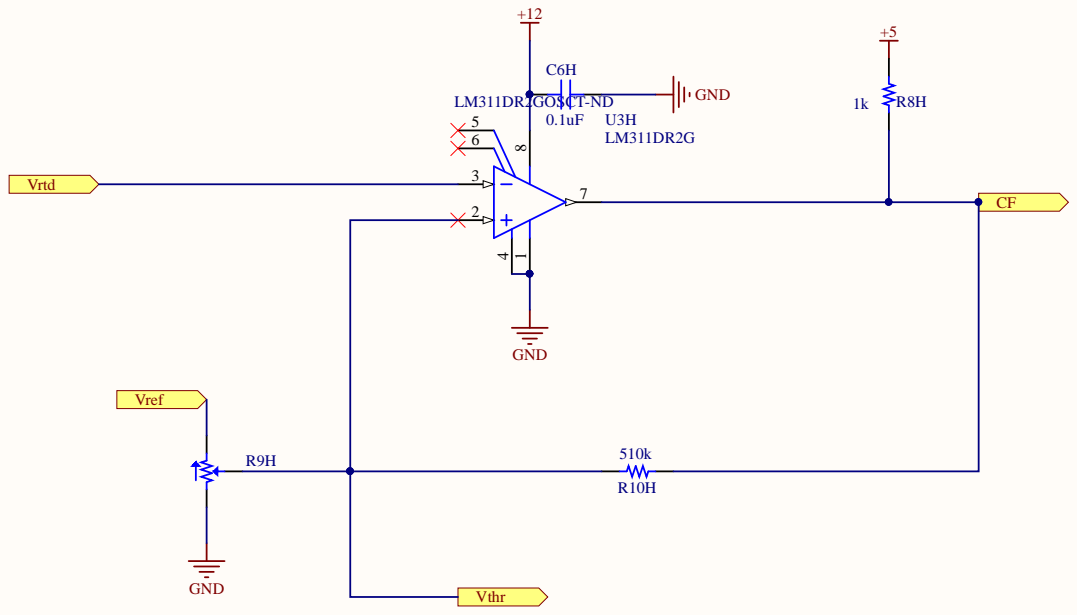
[picture p34: page 34]

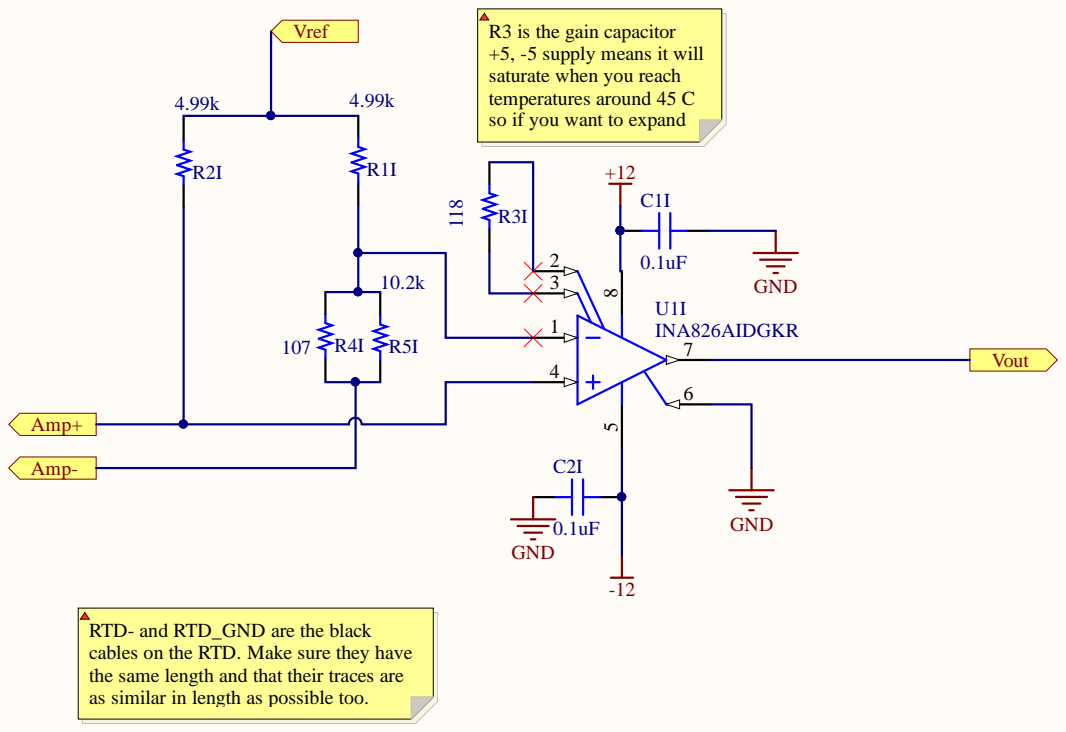
[picture p35: page 35]
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

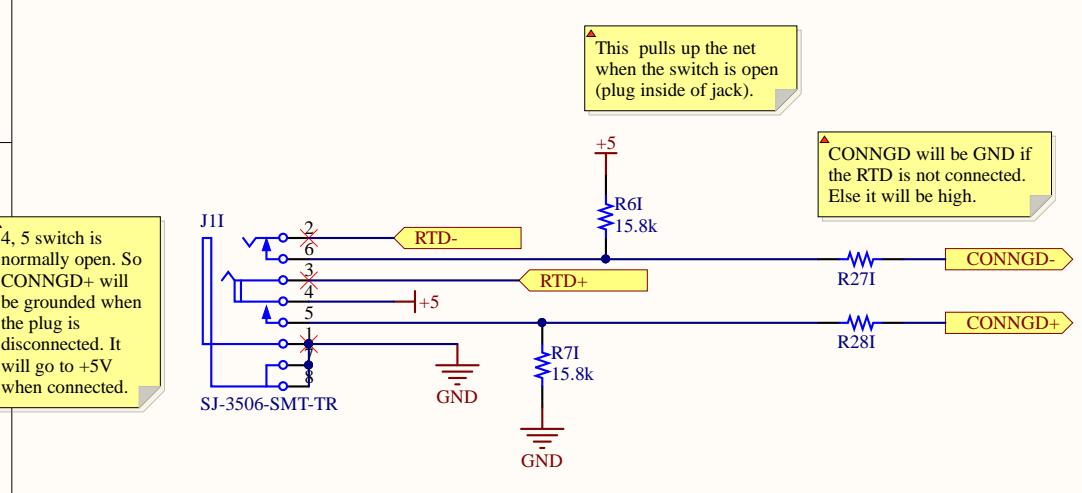
[picture p36: page 36]

This pulls up the net
when the switch is open
(plug inside of jack).

CONNGD will be GND if
the RTD is not connected.
Else it will be high.

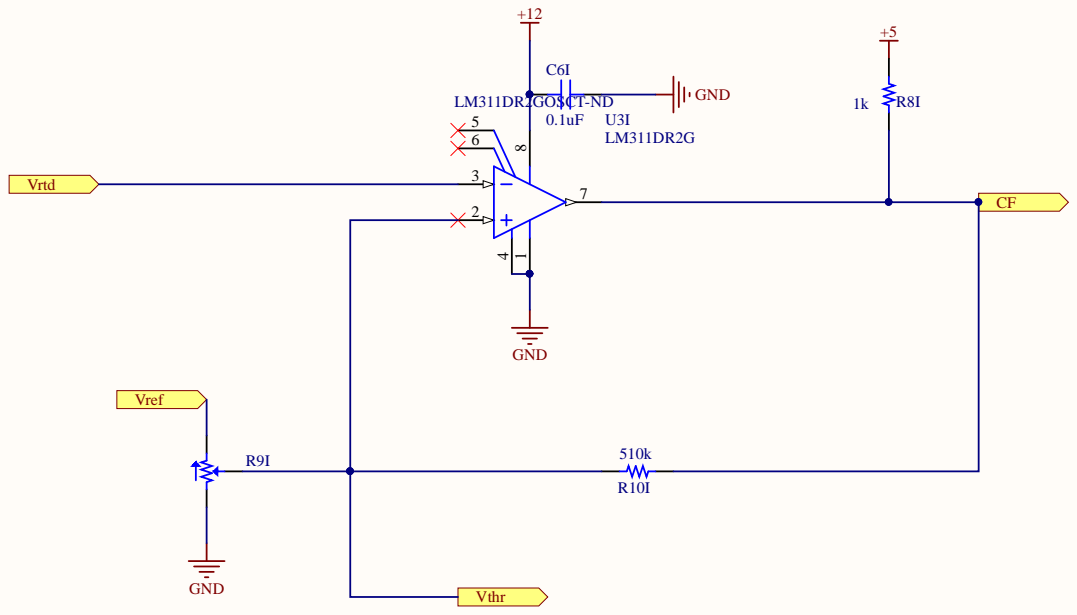
[picture p37: page 37]

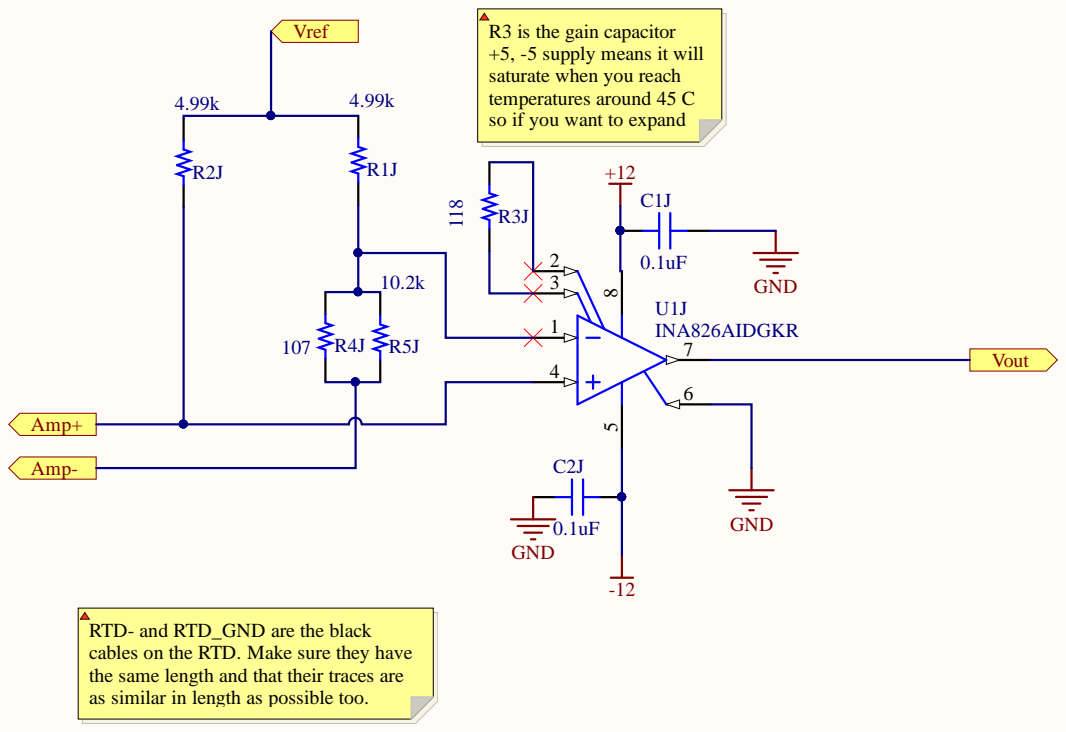
[picture p38: page 38]
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

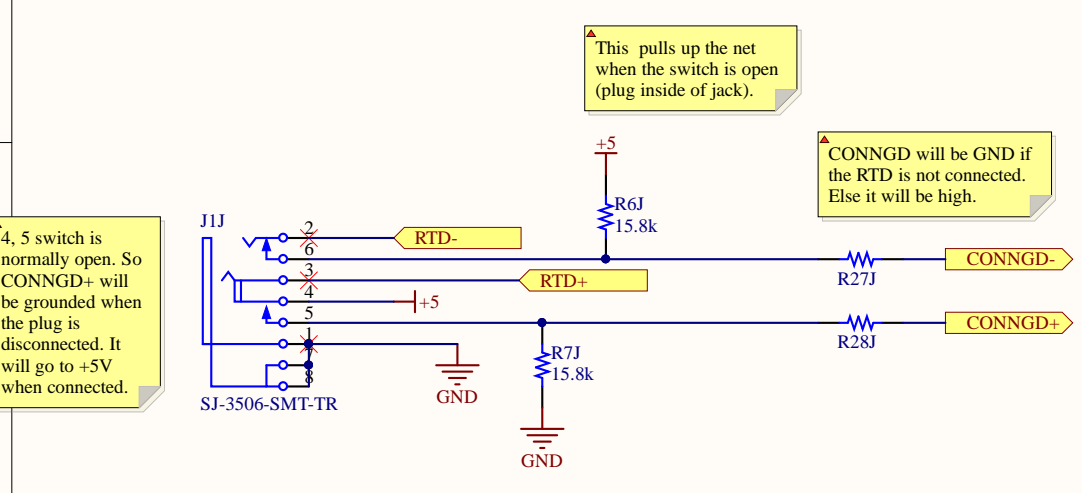
[picture p39: page 39]

This pulls up the net
when the switch is open
(plug inside of jack).

CONNGD will be GND if
the RTD is not connected.
Else it will be high.

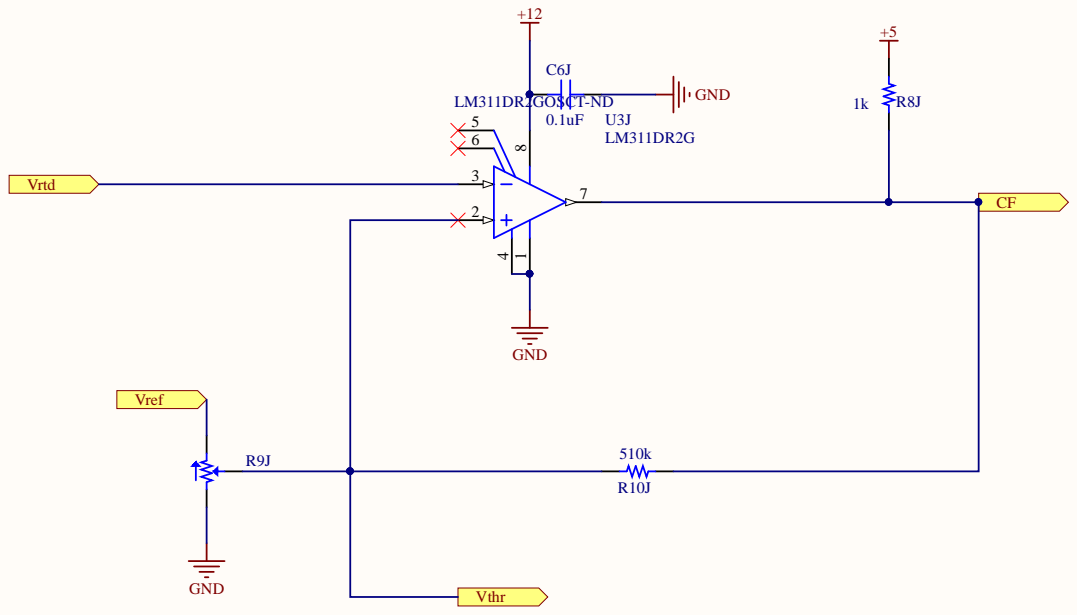
[picture p40: page 40]

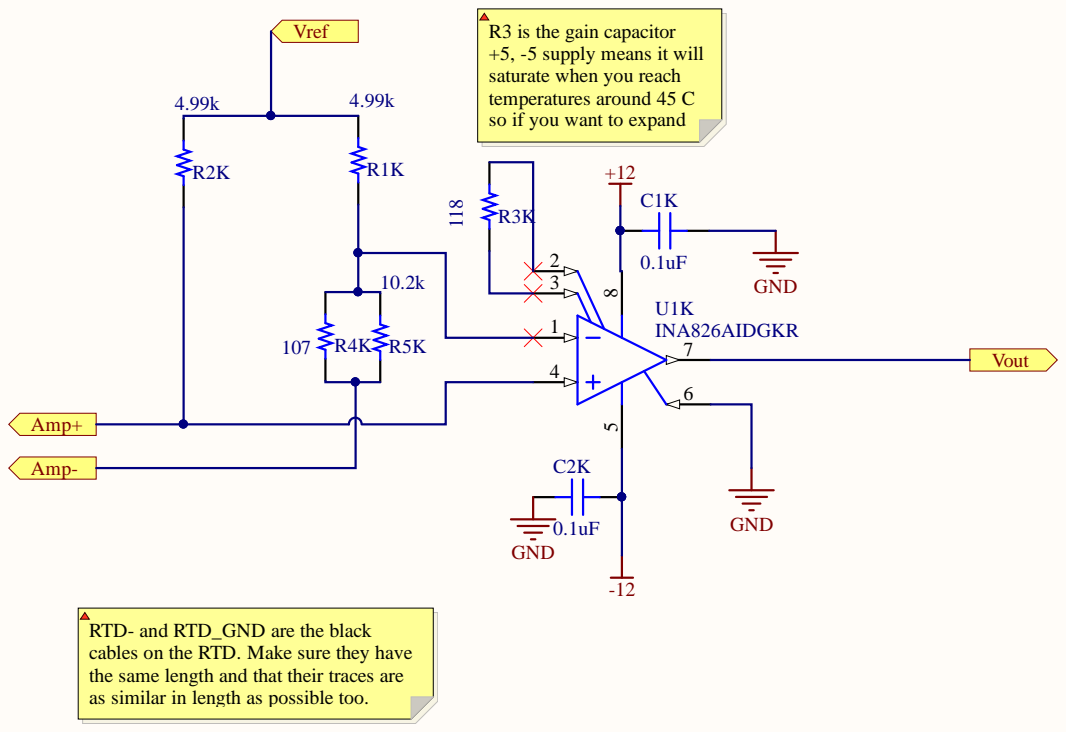
[picture p41: page 41]
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

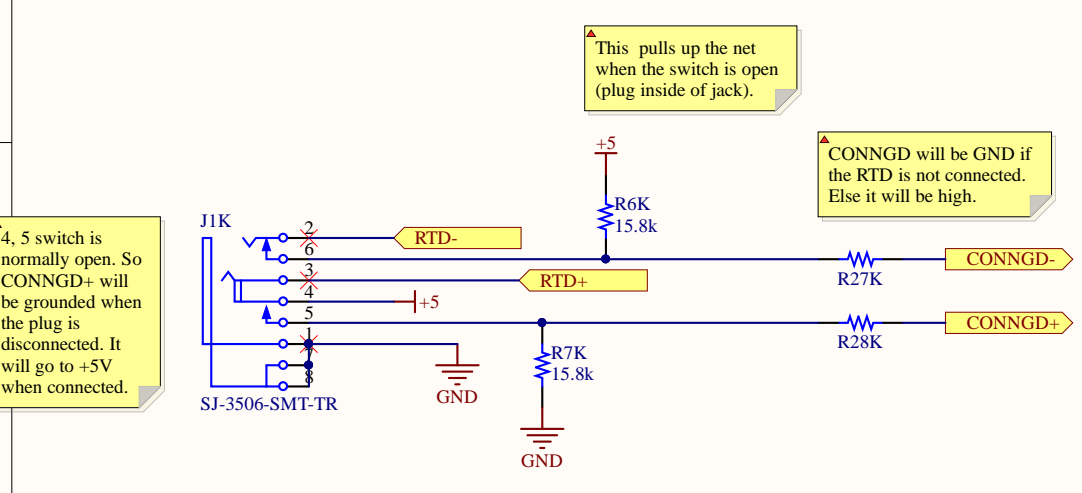
[picture p42: page 42]

This pulls up the net
when the switch is open
(plug inside of jack).

CONNGD will be GND if
the RTD is not connected.
Else it will be high.

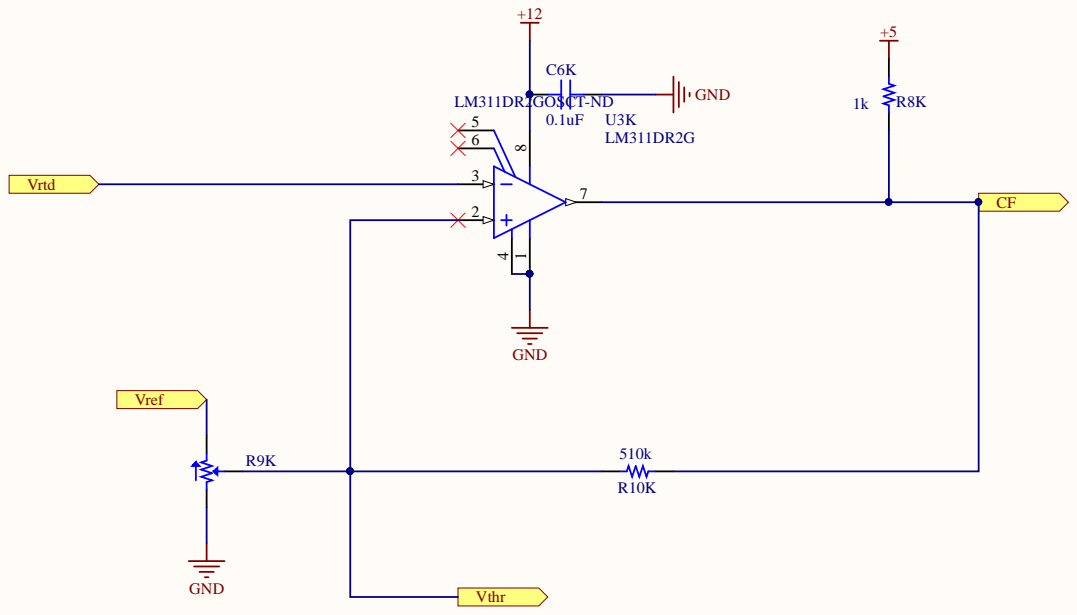
[picture p43: page 43]

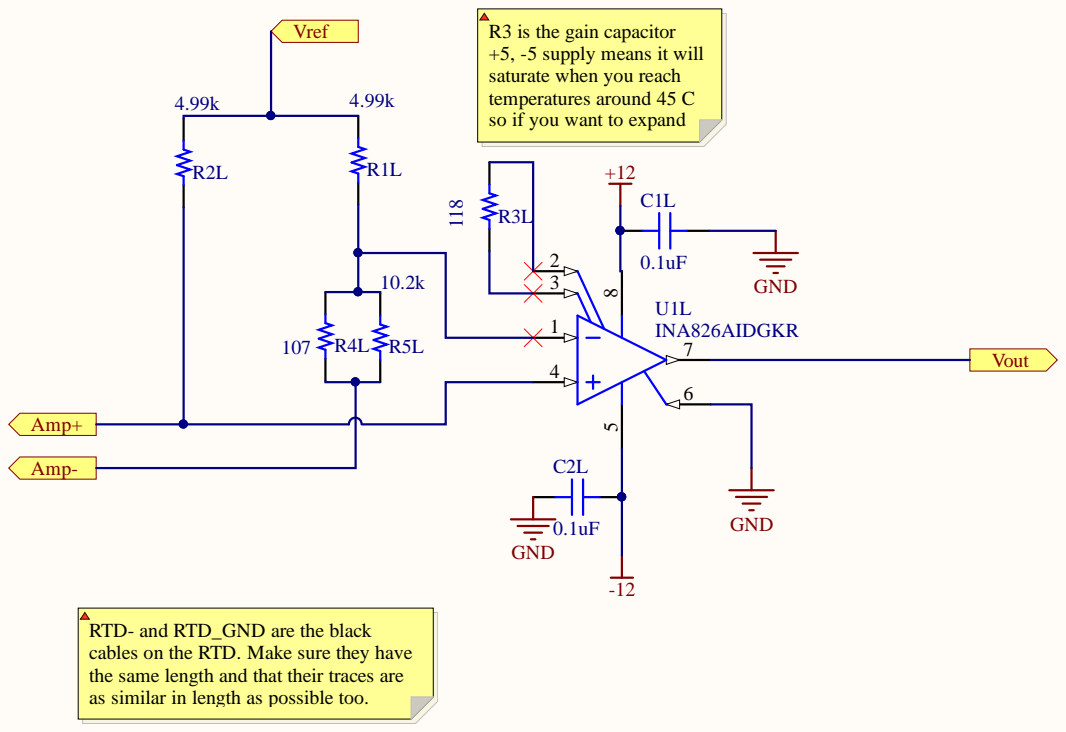
[picture p44: page 44]
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

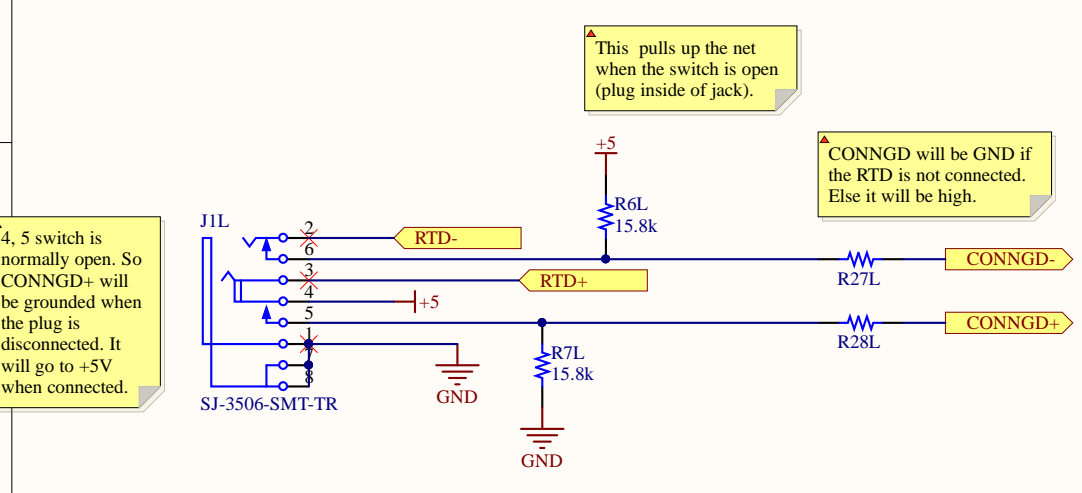
[picture p45: page 45]

This pulls up the net
when the switch is open
(plug inside of jack).

CONNGD will be GND if
the RTD is not connected.
Else it will be high.

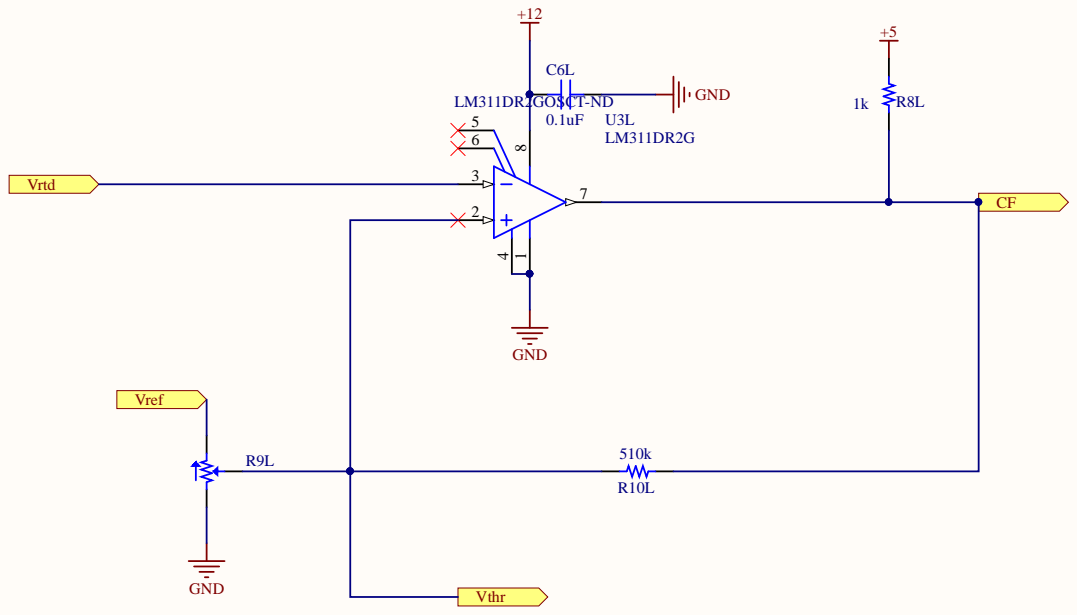
[picture p46: page 46]

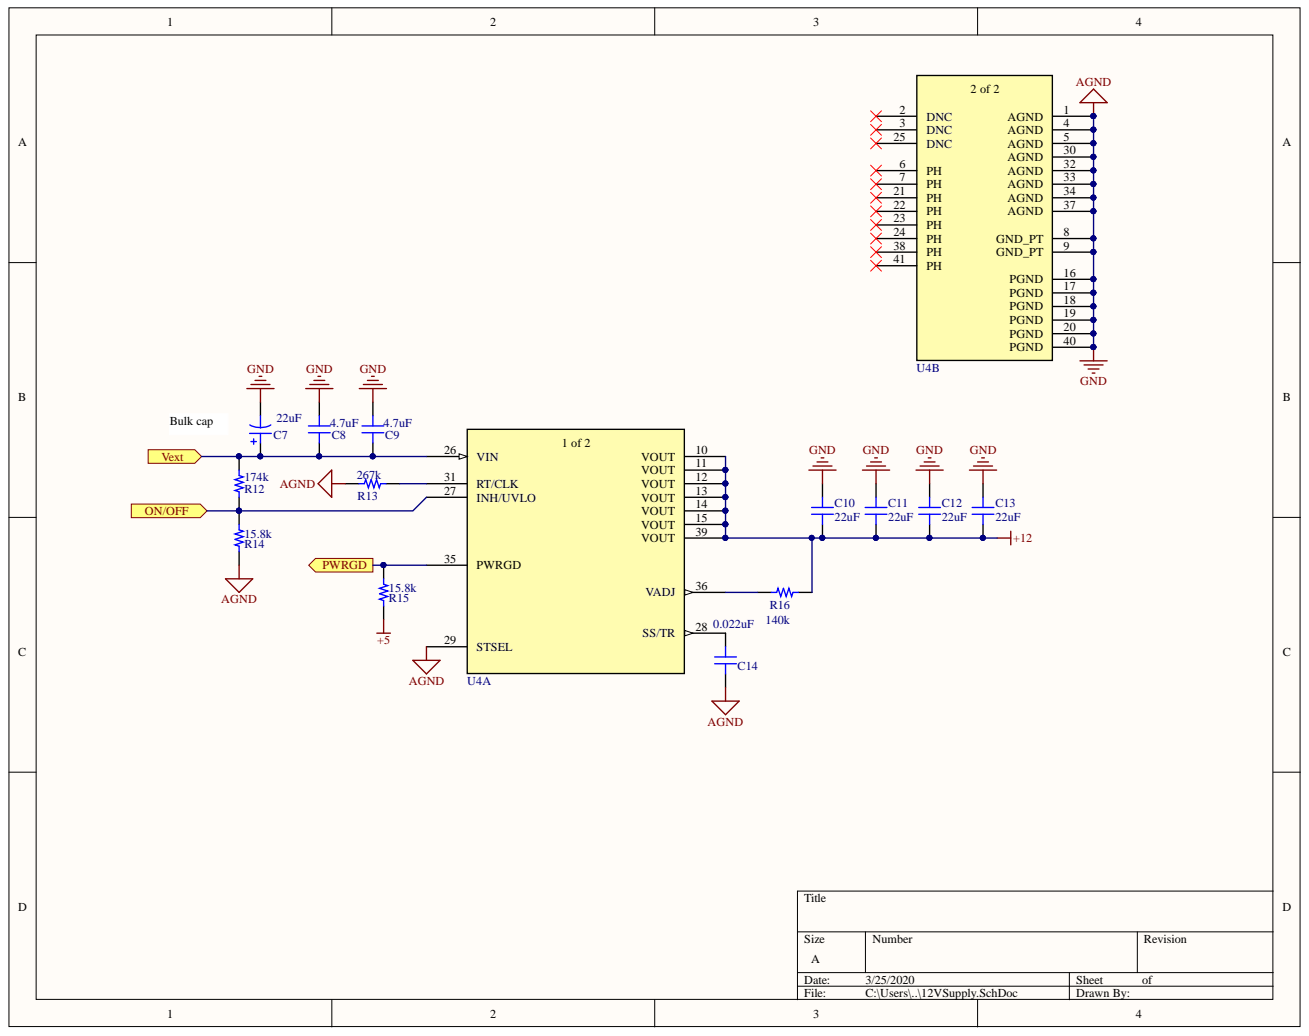
[picture p47: page 47]

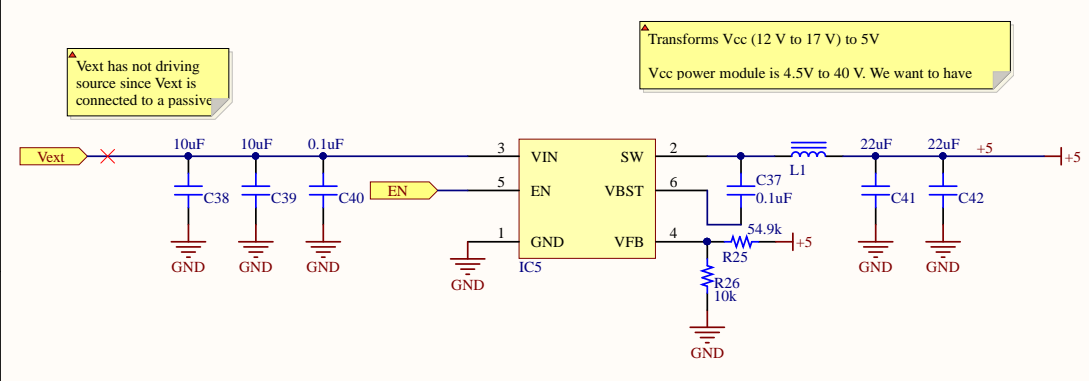
[picture p48: page 48]

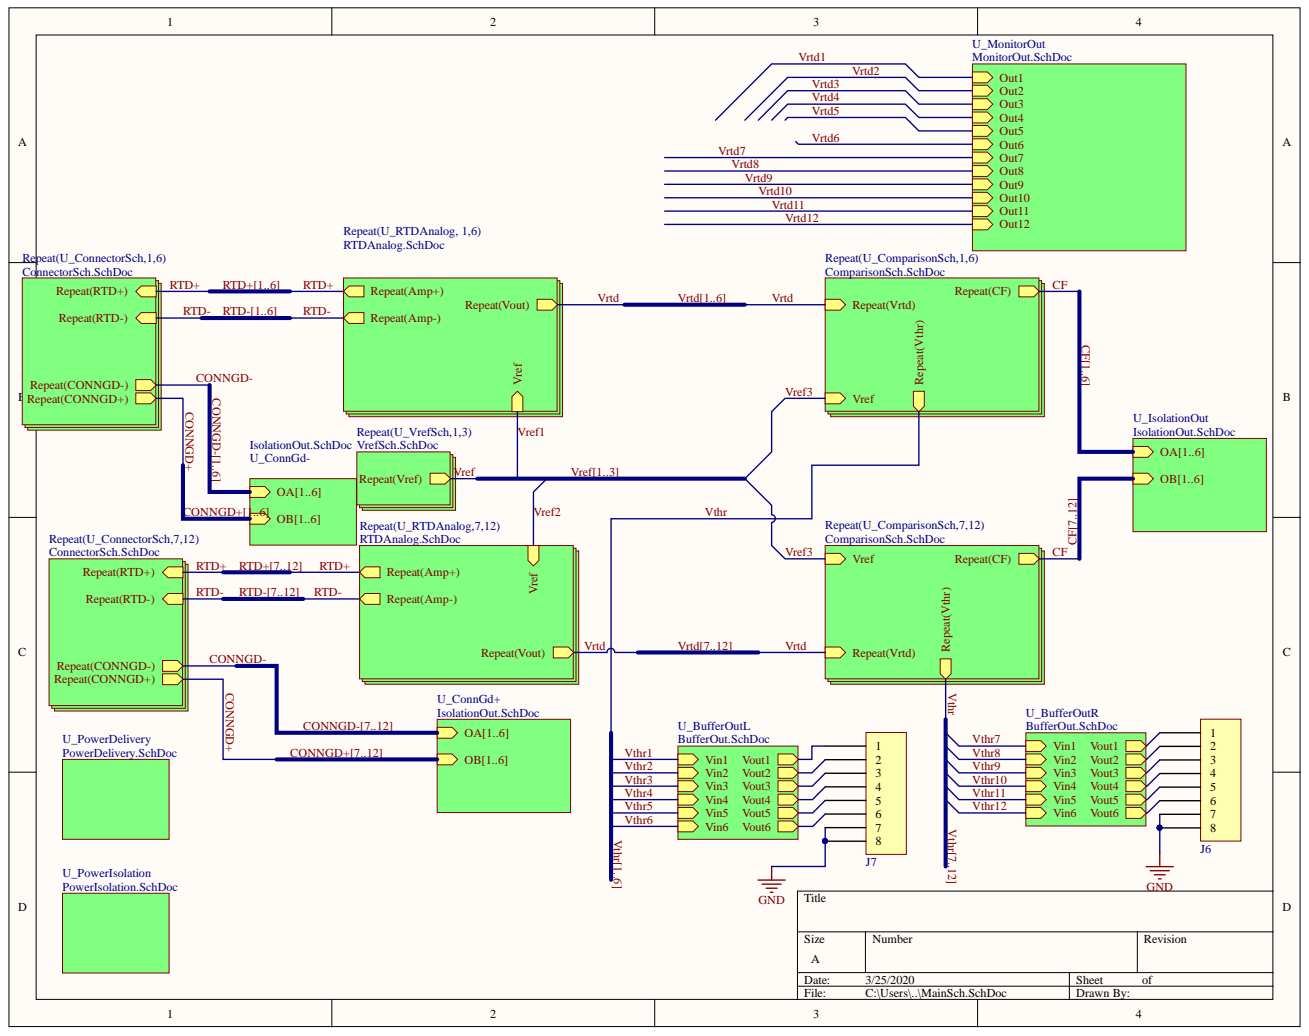
[picture p49: page 49]

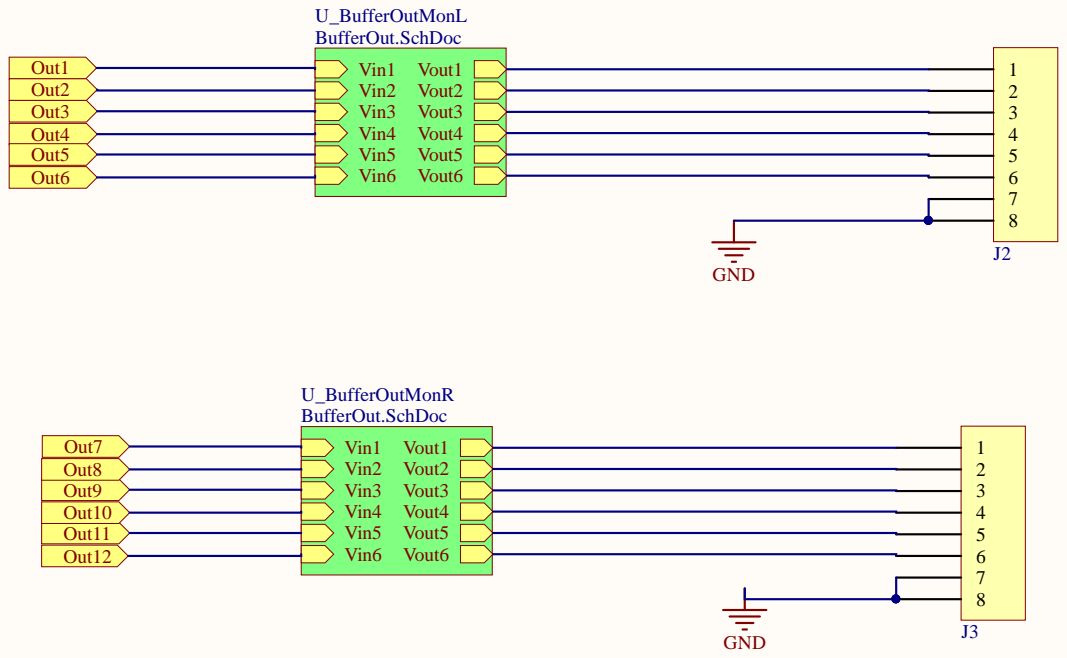
[picture p50: page 50]

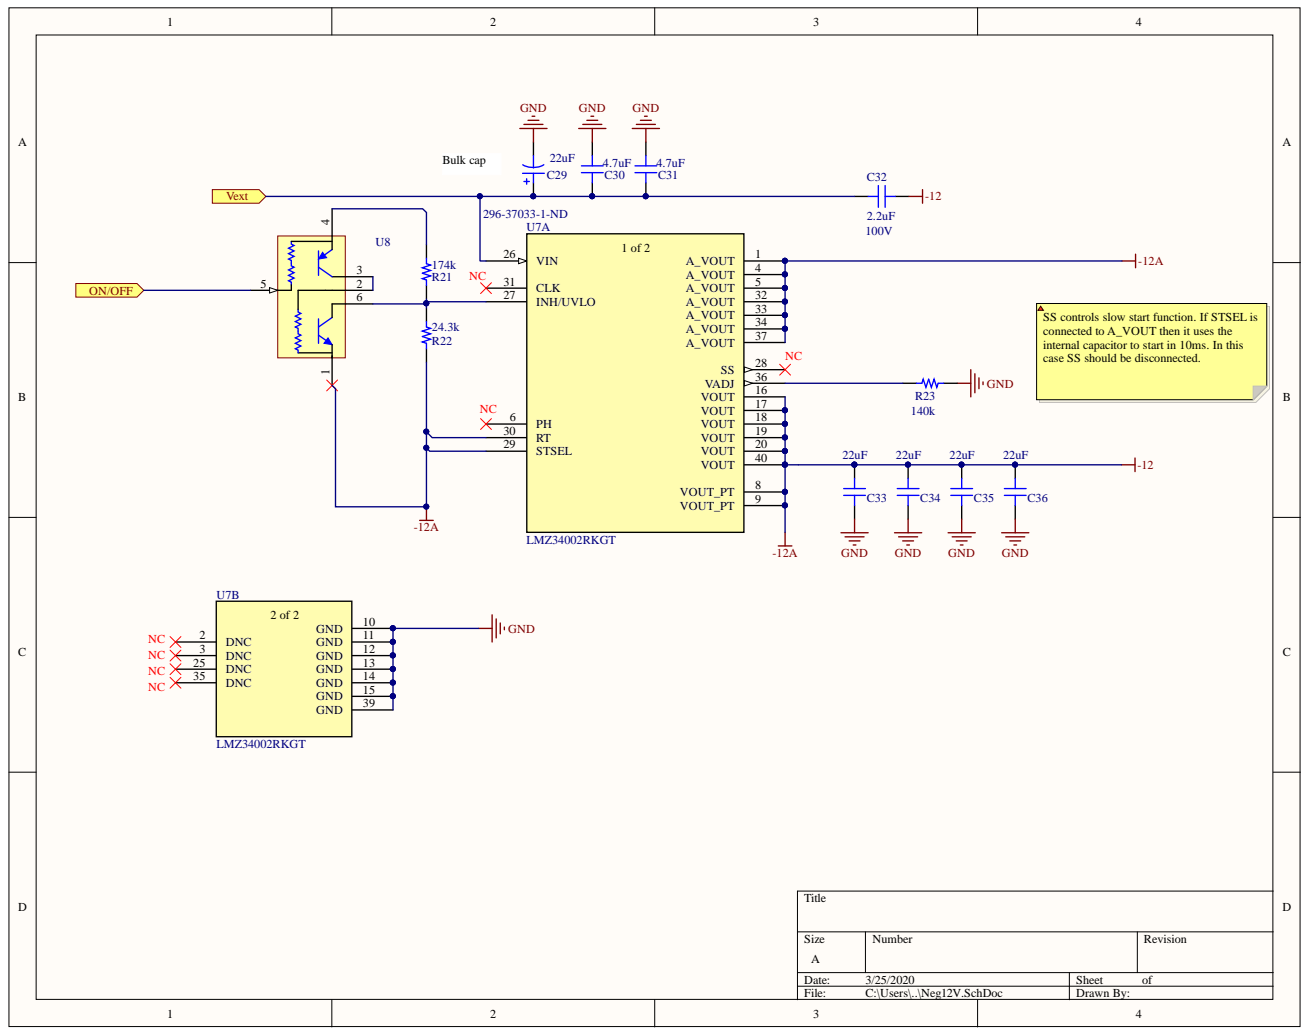
[picture p51: page 51]

SS controls slow start function. If STSEL is
connected to A_VOUT then it uses the
internal capacitor to start in 10ms. In this
case SS should be disconnected.

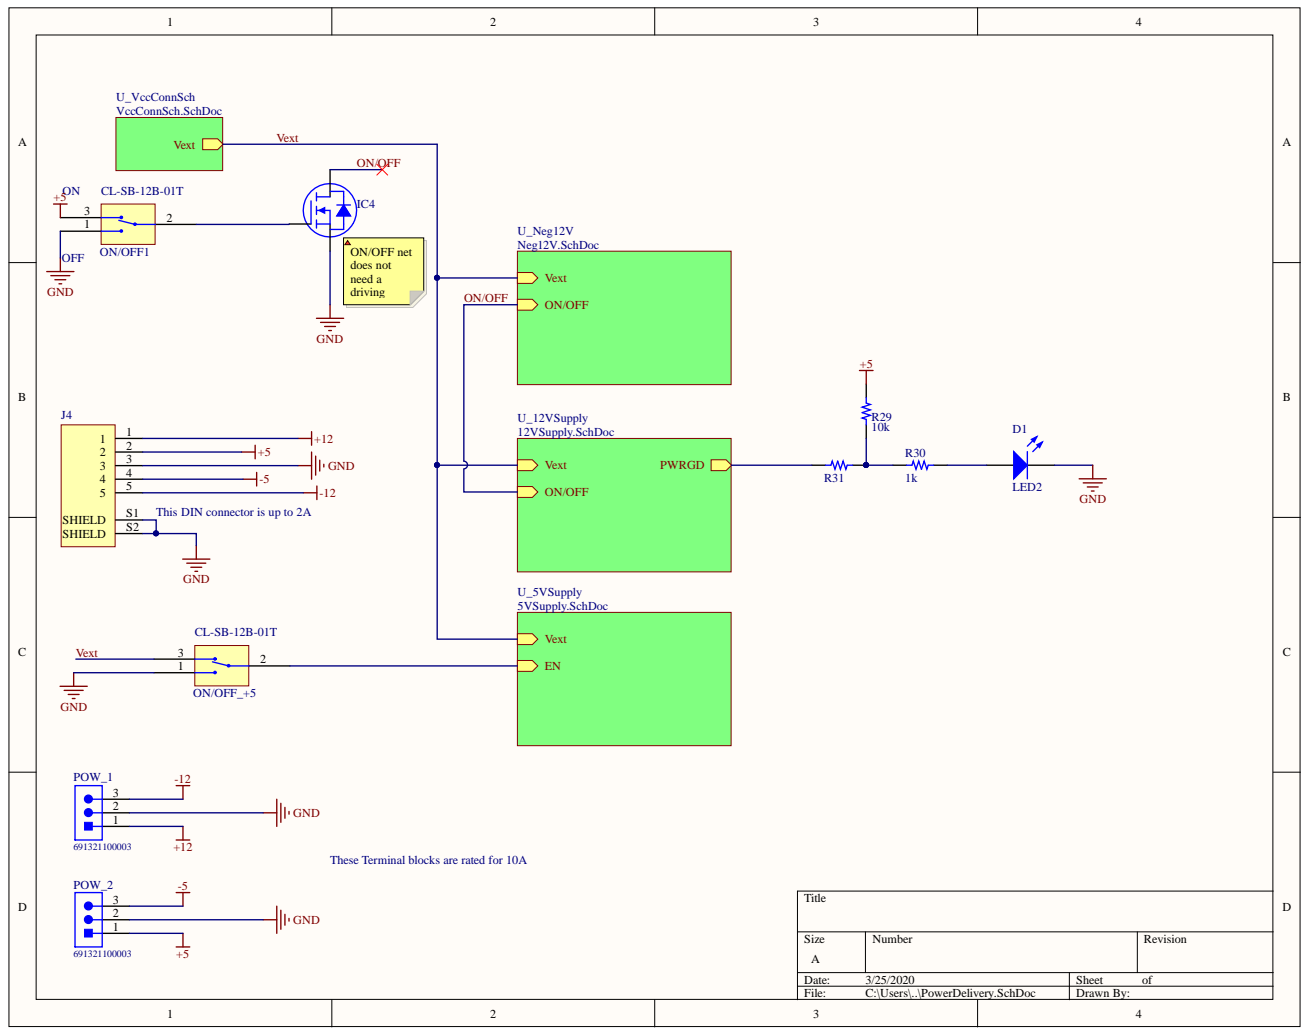
[picture p52: page 52]

This DIN connector is up to 2A

These Terminal blocks are rated for 10A

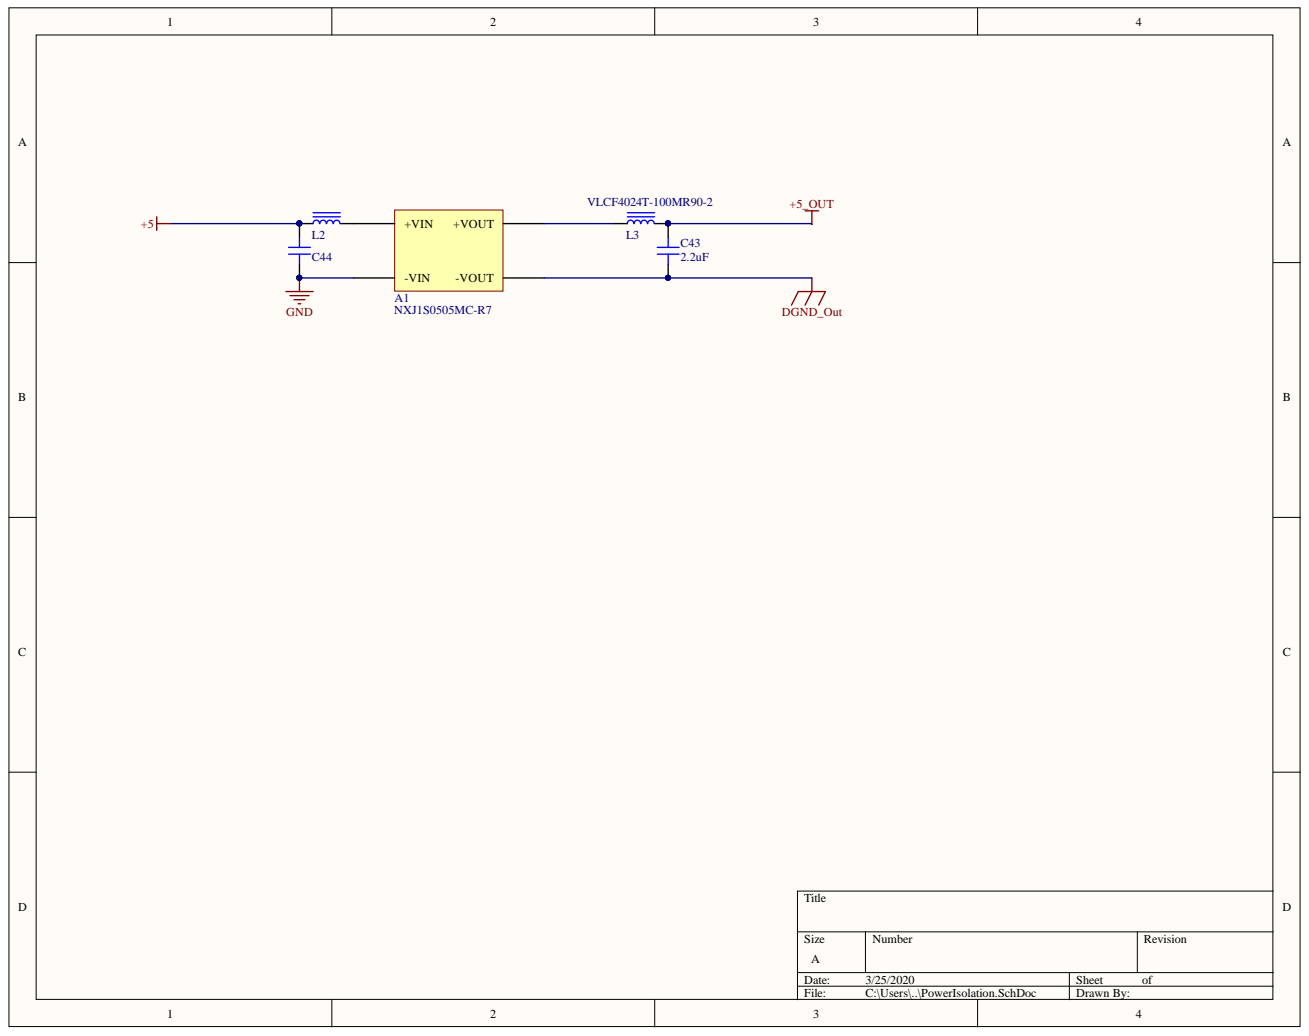
[picture p53: page 53]

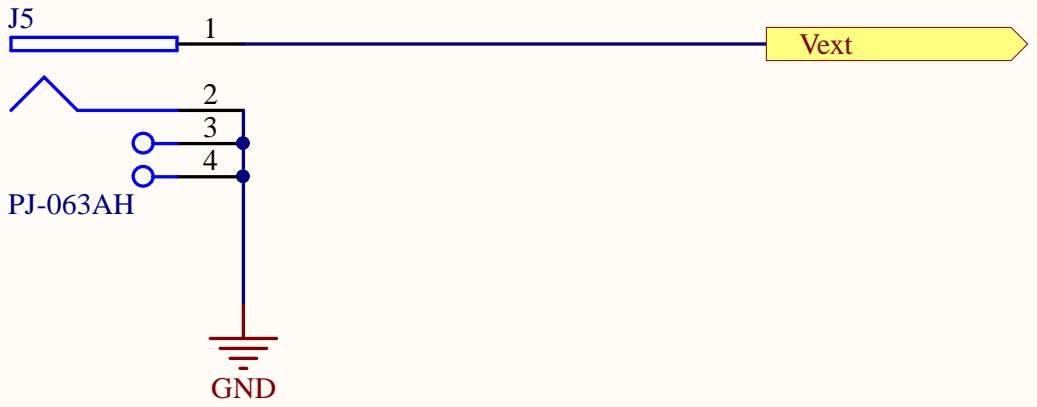
[picture p54: page 54]

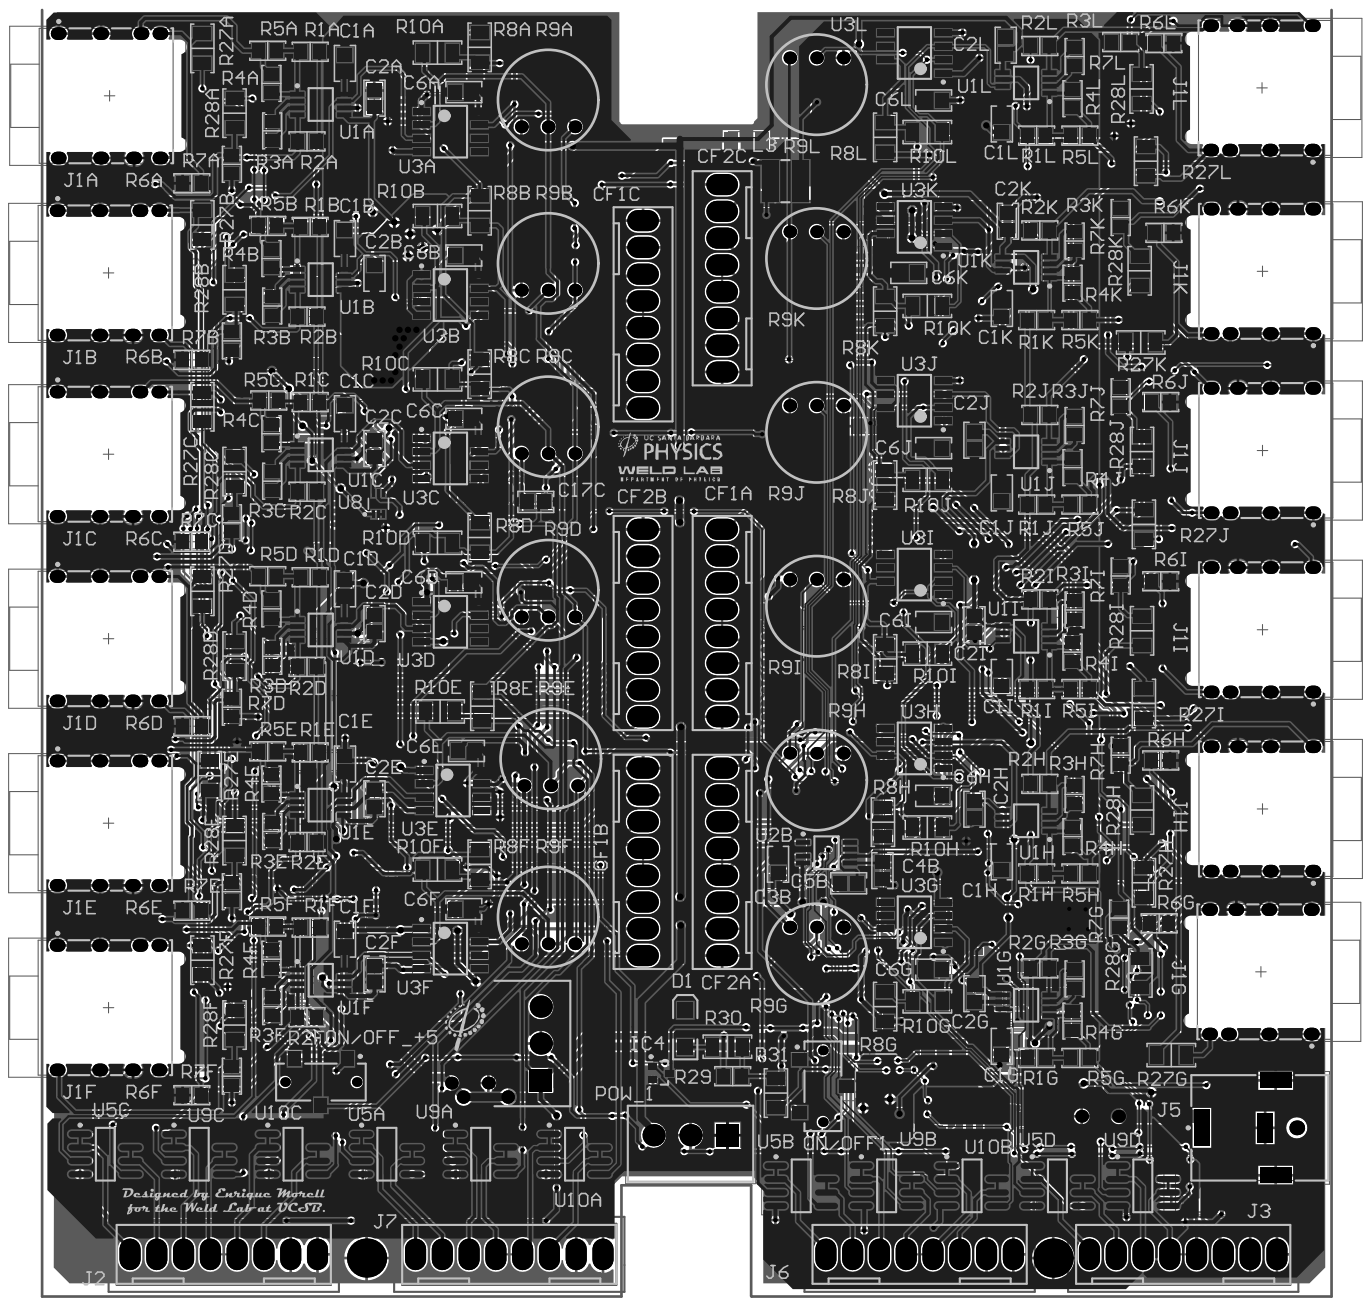
[picture p55: page 55]

# Board Stack Report
