emorell96/WaterSystemLock/RTD Measurement/Simulations by TI/RTD_Linearization_v7.xls

RTD Linearization |  |  | Temp | RTD | RTD % | RTD | Output | Output
 |  |  | °C | ohms | Nonlin. | Voltage | Vout | Nonlin
Entries | Value | Units | 0 | 100.000 | 0.00% | 0.09814 | 0.00000 | 0.000%
Low-Scale Temp | 0 | 'C | 20 | 107.793 | 0.27% | 0.10612 | 0.49984 | -0.003%
High-Scale Temp | 200 | 'C | 40 | 115.541 | 0.49% | 0.11409 | 0.99978 | -0.004%
Low-Scale Vout | 0 | V | 60 | 123.242 | 0.64% | 0.12207 | 1.49981 | -0.004%
High-Scale Vout | 5 | V | 80 | 130.897 | 0.73% | 0.13005 | 1.99989 | -0.002%
Vref | 5 | V | 100 | 138.505 | 0.76% | 0.13803 | 2.50000 | -2.664535259e-14%
R1= | 4990 | ohms | 120 | 146.068 | 0.73% | 0.14601 | 3.00011 | 0.002%
 |  |  | 140 | 153.584 | 0.64% | 0.15399 | 3.50020 | 0.004%
 |  |  | 160 | 161.054 | 0.49% | 0.16197 | 4.00022 | 0.004%
Data for Platinum RTD. Pt100=100 ohms @ 0'C |  |  | 180 | 168.478 | 0.27% | 0.16995 | 4.50017 | 0.003%
RTD Ro= | 100 | ohms at 0'C | 200 | 175.856 | 0.00% | 0.17792 | 5.00000 | 0.000%
A= | 0.0039083 | Linear term
B= | -5.775e-07 | Quadratic term
C= | -4.23225e-12 | 4th-order term
Scratchpad Calculations
(first part of R5) | 3.984567062e+11
(more of R5) | 4.797814539e+11
(even more of R5) | -9343934563
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
