emorell96/WaterSystemLock/RTD Measurement/Quality Control/v1/chJ/ina 826/pin1.bmp

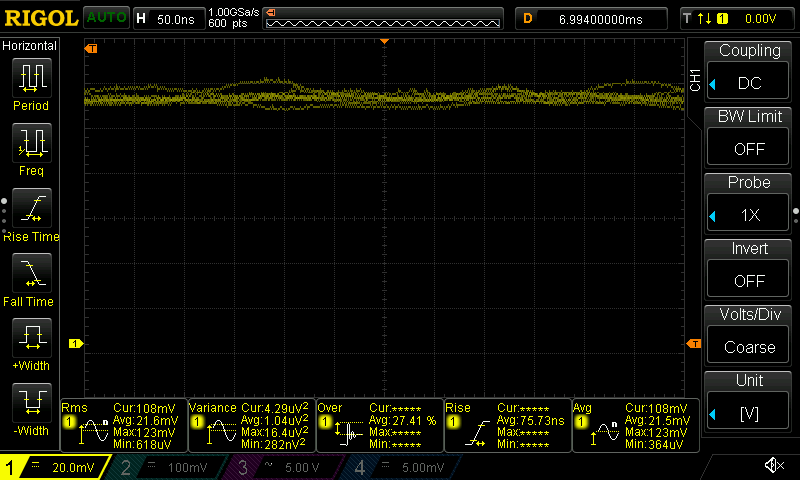
RTD Measurement/Quality Control/v1/chJ/ina 826/pin1.bmp
