emorell96/WaterSystemLock/RTD Measurement/Quality Control/v1/chJ/ina 826/pin 7 ina 826.bmp

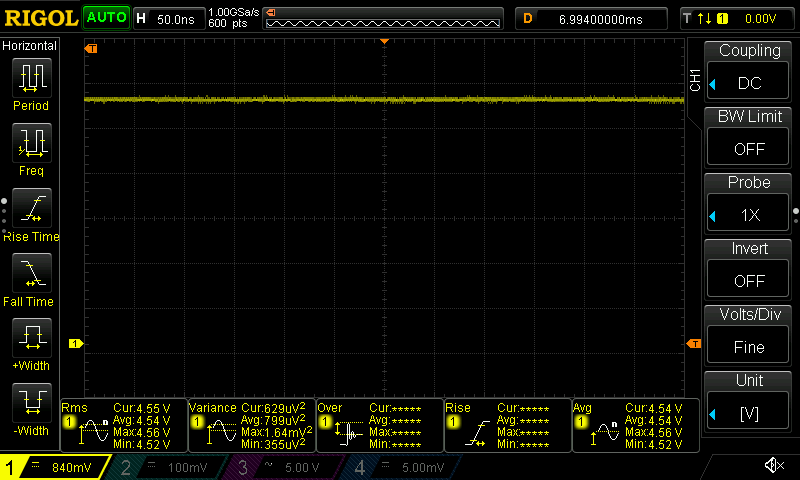
RTD Measurement/Quality Control/v1/chJ/ina 826/pin 7 ina 826.bmp
