emorell96/WaterSystemLock/RTD Measurement/simulation temp vs out.jpg

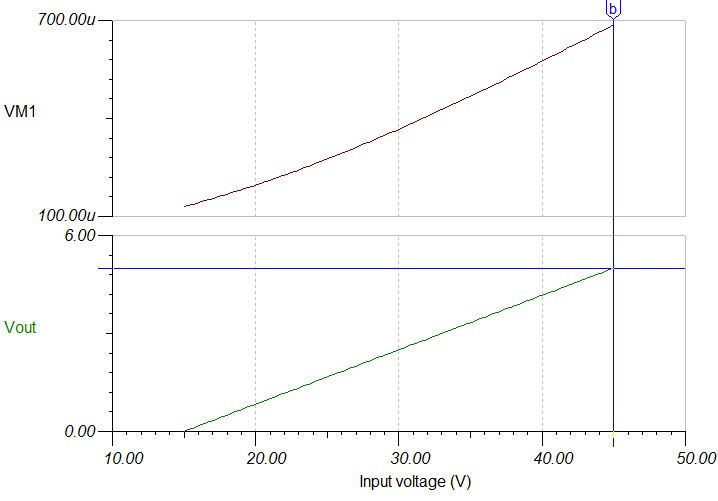
RTD Measurement/simulation temp vs out.jpg
