emorell96/WaterSystemLock/UHV Gate Valve Control/UHV Gate Valve Control.pdf

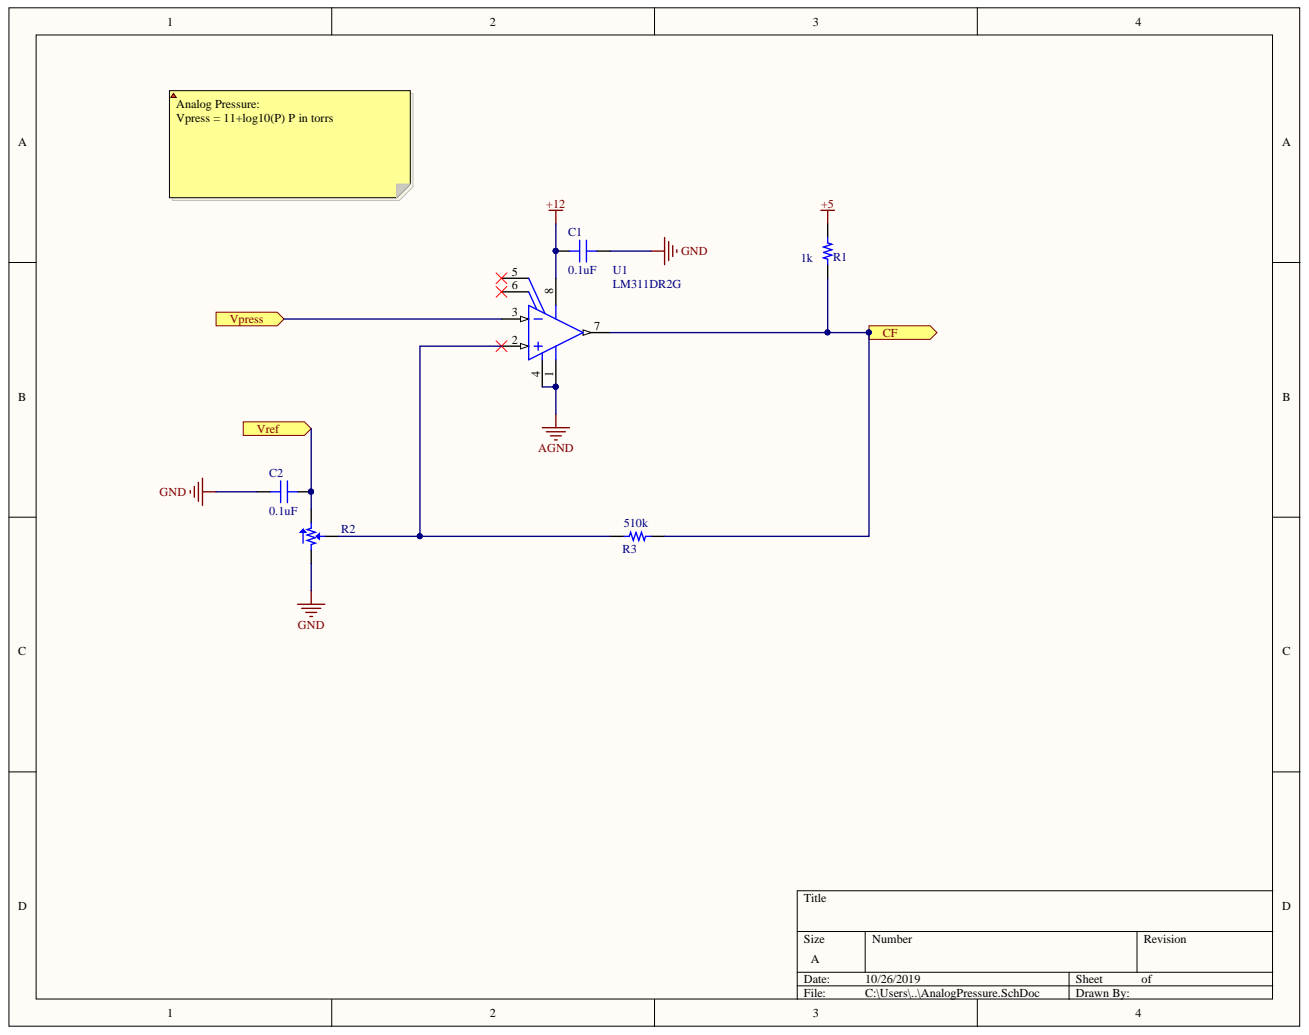
[picture p60: page 1]

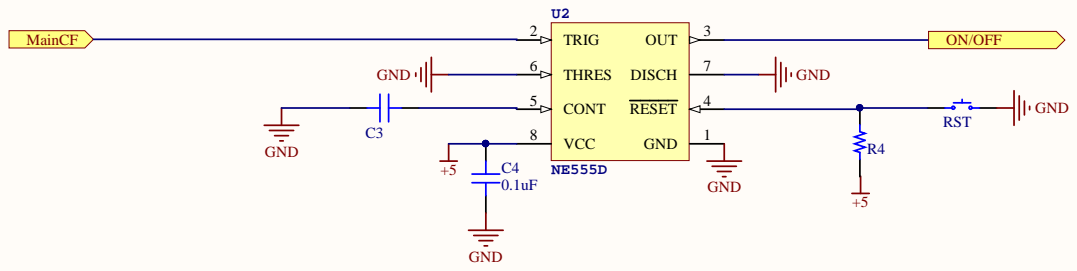
[picture p61: page 2]

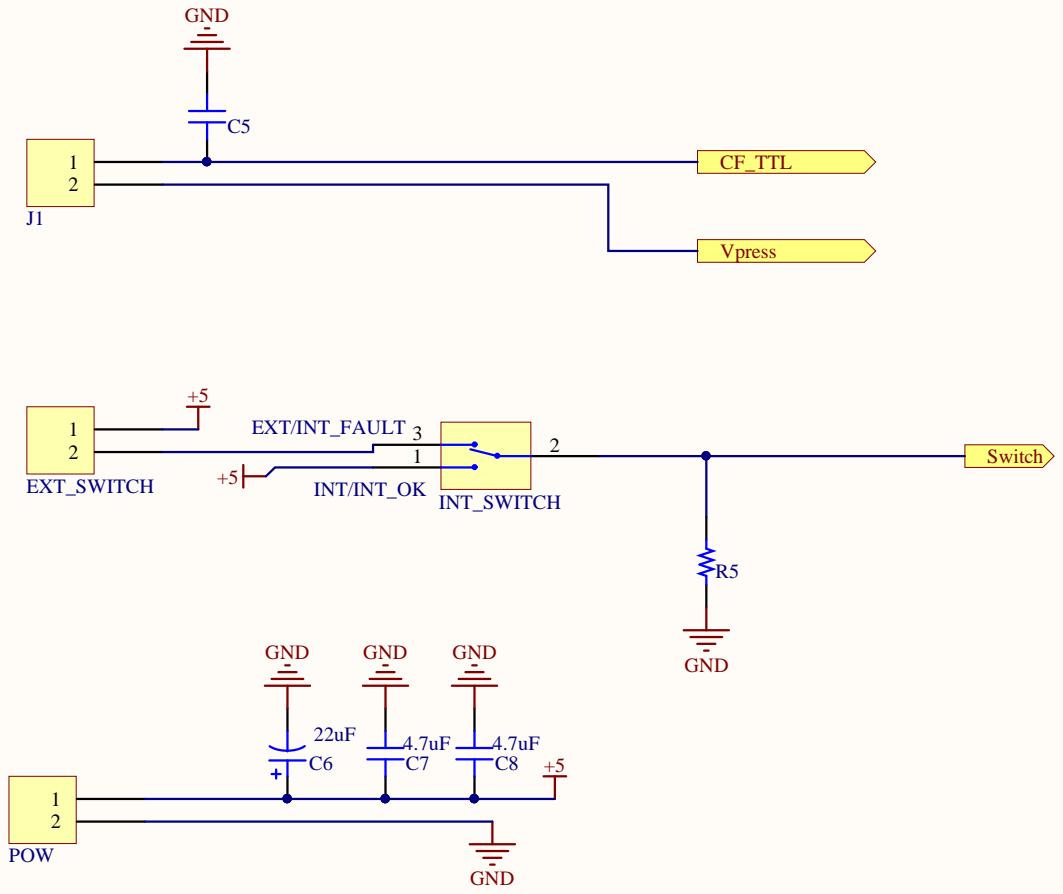
[picture p62: page 3]

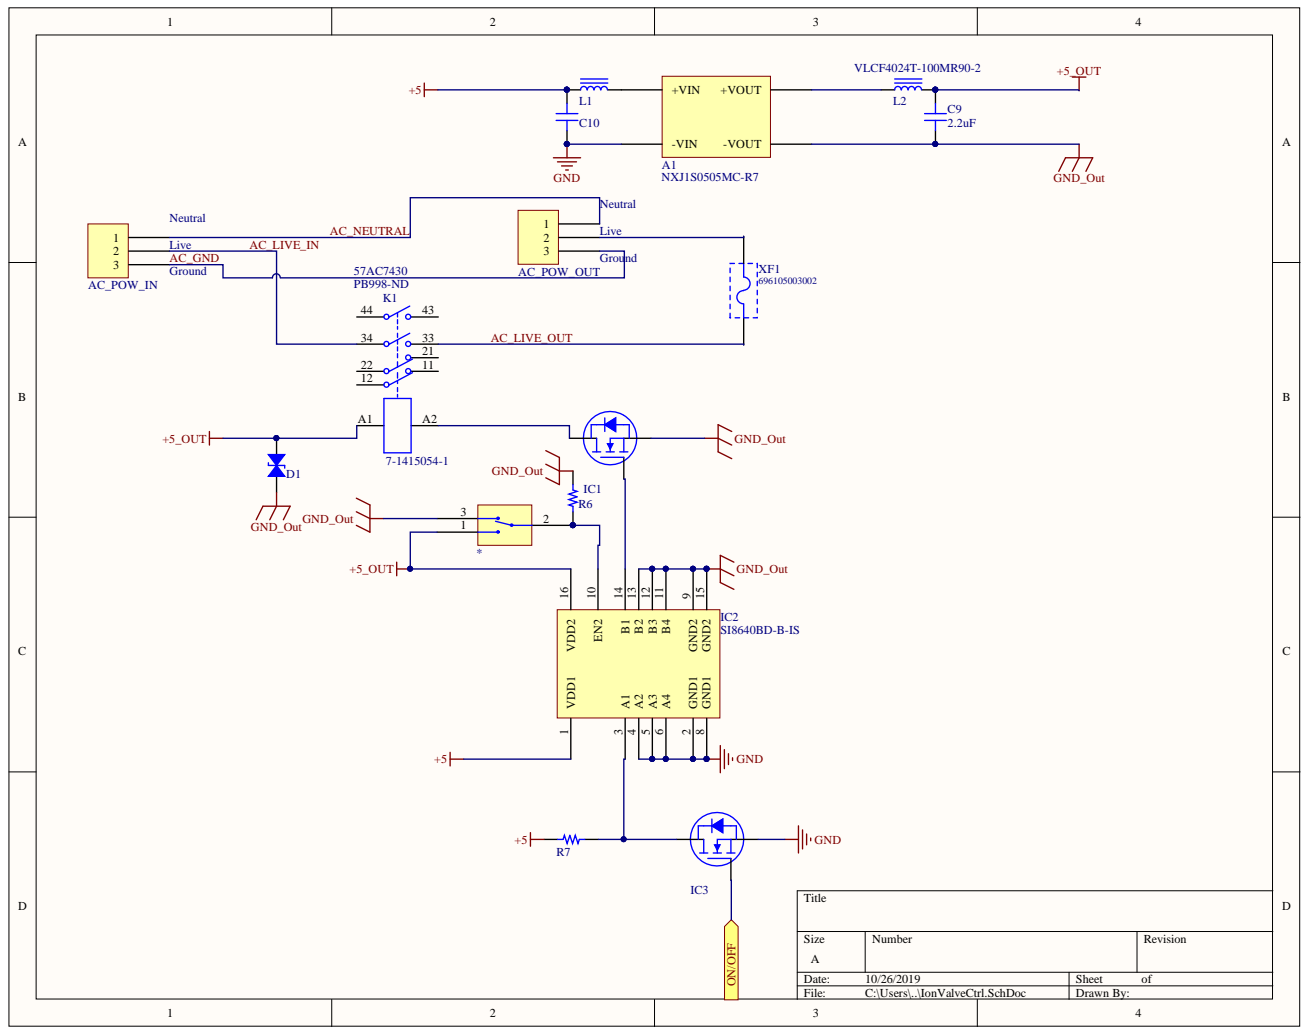
[picture p63: page 4]

Live AC_LIVE_IN | 2 3

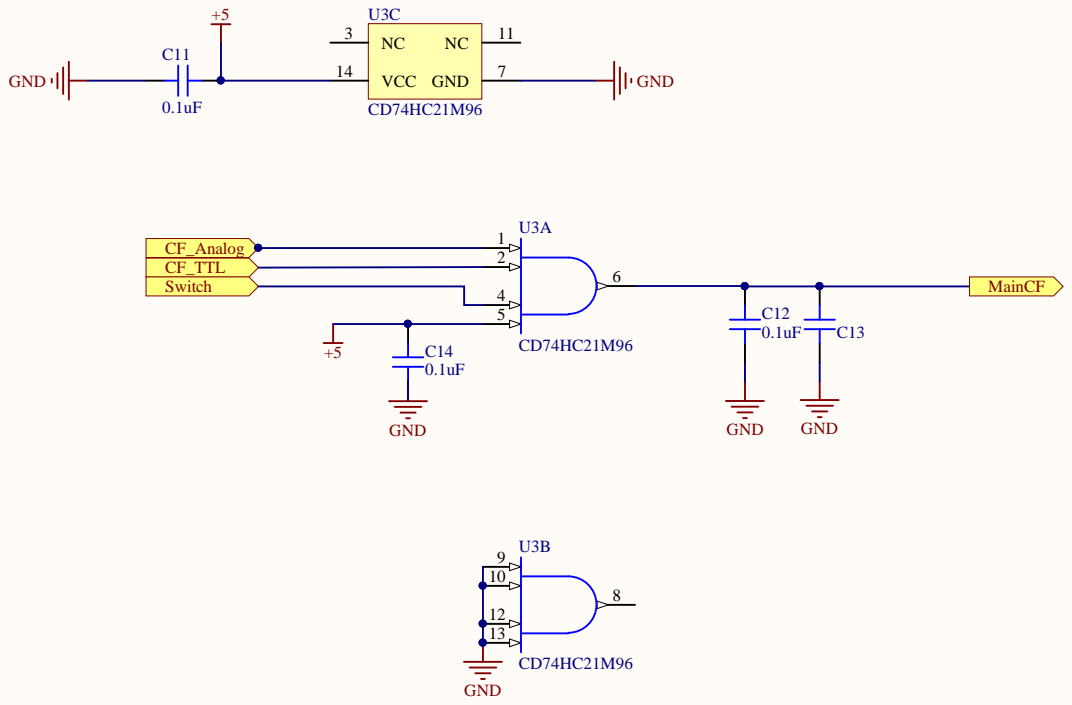
[picture p64: page 5]

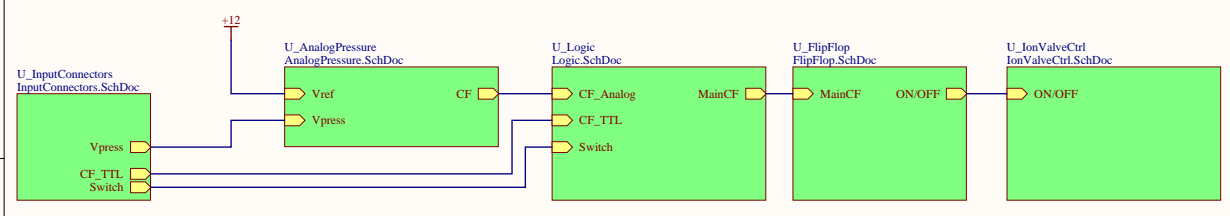
[picture p65: page 6]

Comment | Description | Designator | Footprint | LibRef | Quantity
CL-SB-12B-01T | SWITCH SLIDE SPDT [NoValue],INT_SWITCSW_CL-SB-12B-01 | | | CL-SB-12B-01T | 2
NXJ1S0505MC-R7 | DC/DC SM 1W 5V-5V A1 | | MURATA NXJ1 | NXJ1S0505MC-R7 | 1
691508110303 | CONN TERM BLK 3POSAC_POW _IN,AC_POWWURTH69150811030691508110303 | | | | 2
0.1uF | CAP CER 0.1UF 25V X7C1,C2,C4, C11, C12,CAP0805/2012 | | | CL21B104KACNNNC | 6
10000pF | CAP CER 10000PF25VC3,C5 | | CAP 0805/2012 | CL21B103KAANNNC | 2
22uF | CAP ALUM 22UF 20% C6 | | CAP AL TH D8 L3.5 H1EEU-FC2A220 | | 1
4.7uF | CAP CER 4.7UF 50V X5C7,C8 | | CAP 1206/3216 - 1.0MC3216X5R1H475K085 | | 2
2.2uF | CAP CER 2.2UF 100V X7C9 | | CAP 1206/3216 | CL31B225KCHSNNE | 1
4.7uF | CAP CER 4.7UF 10V X7C10 | | CAP 1206/3216 - 1.8MCL31B475KPHNNNE | | 1
100pF | CAP CER 100PF 10V NC13 | | CAP 0201/0603 | 0201ZA101JAT2A | 1
SM15T15CA | TVS DIODE 12.8VWMD1 | | ST DO214AB SMC | SM15T15CA | 1
282834-2 | TERM BLOCK 2POS SIEXT _SWITCH,J1,POWTE 282834-2 | | | 282834-2 | 3
BSS138WH6327XTSA1MOSFET N-CH 60V 28IC1, IC3 | | | INFINEON SOT-323-3BSS138WH6327XTSA1 | | 2
SI8640BD-B-IS | DGTL ISO 5KV 4CH GEIC2 | | SI LABS SOIC-16 WIDSI8640BD-B-IS | | 1
7-1415054-1 | Force Guided Relay SRK1 | | TECO-3-1415055-1-10CMP-1684-00019-1 | | 1
VLCF4024T-4R7N1R4-FIXED IND 4.7UH 1.43L1 | | | TDKVLCF4024-2 | VLCF4024T-4R7N1R4- | 1
VLCF4024T-100MR90-FIXED IND 10UH 900ML2 | | | TDKVLCF4024-2 | VLCF4024T-100MR90- | 1
1k | RES SMD 1K OHM 1%R1 | | RES 1206/3216 | ERJ-8ENF1001V | 1
20k | TRIMMER 20K OHM 3/R2 | | POTMODEL91A | 91AR20KLF | 1
510k | RES SMD 510K OHM 5R3 | | RES 1206/3216 | ERJ-8GEYJ514V | 1
10k | RES SMD 10K OHM 1%R4,R5, R6, R7 | | RES 1206/3216 | ERJ-8ENF1002V | 4
AB11AH-HC | SWITCH PUSH SPST-NR ST | | NKK AB11AH-HC | AB11AH-HC | 1
LM311DR2G | Single Comparator, 5 U1 | | ON SC-SOIC-8 -751-07CMP-1 305-0005 8-1 | | 1
NE555D | Precision Timer, 4.5 toU2 | | D0008A_L | CMP-2000-06840-1 | 1
CD74HC21M96 | High Speed CMOS LogU3 | | D0014A_N | CMP-0777-00096-3 | 1
696105003002 | WR-FSH Fuse Holder BXF1 | | 69610500300 2 | CMP-1502-00234-1 | 1
