emorell96/WaterSystemLock/(list of files, drawings)

Other design files:
Coil System/Coil System.PrjPcb
Coil System/CurrentSensing.SchDoc
Interlock Draft/BoosterSystem.SchDoc
Interlock Draft/BroidaSystem.SchDoc
Interlock Draft/ChillerSystem.SchDoc
Interlock Draft/HeatingSystem.SchDoc
Interlock Draft/Interlock Draft.PrjPcb
Interlock Draft/InterlockDraftSch.SchDoc
Interlock Draft/LaserWater.SchDoc
Interlock Draft/LithiumUHV.SchDoc
Interlock Draft/MagnetWaterSystem.SchDoc
Interlock Draft/PlumbingMonitoring.SchDoc
Interlock Draft/StrontiumMagnetWater.SchDoc
Interlock Draft/StrontiumUHV.SchDoc
Interlock Draft/UHVMonitoring.SchDoc
Interlock Draft/WaterSystem1.SchDoc
RTD Measurement/5VSupply.SchDoc
RTD Measurement/12VSupply.SchDoc
RTD Measurement/BufferOut.SchDoc
RTD Measurement/ComparisonSch.SchDoc
RTD Measurement/ConnectorSch.SchDoc
RTD Measurement/ConnectOut.SchDoc
RTD Measurement/History/RTDMeasurement.~(10).PrjPcb/RTDMeasurement.~(10).PrjPcb
RTD Measurement/IsolationOut.SchDoc
RTD Measurement/MainSch.SchDoc
RTD Measurement/MonitorOut.SchDoc
RTD Measurement/Neg5V.SchDoc
RTD Measurement/Neg12V.SchDoc
RTD Measurement/Negative5VSupply.SchDoc
RTD Measurement/PCB_Project/PCB_Project.PrjPcb
RTD Measurement/PowerDelivery.SchDoc
RTD Measurement/PowerIsolation.SchDoc
RTD Measurement/RTDAnalog.SchDoc
RTD Measurement/RTDMeasurement.PrjPcb
RTD Measurement/VccConnSch.SchDoc
RTD Measurement/VrefSch.SchDoc
UHV Gate Valve Control/AnalogIsolation.SchDoc
UHV Gate Valve Control/AnalogPressure.SchDoc
UHV Gate Valve Control/BufferOut.SchDoc
UHV Gate Valve Control/FlipFlop.SchDoc
UHV Gate Valve Control/InputConnectors.SchDoc
UHV Gate Valve Control/IonValveCtrl.SchDoc
UHV Gate Valve Control/Logic.SchDoc
UHV Gate Valve Control/MainSch.SchDoc
UHV Gate Valve Control/UHV Gate Valve Control.PrjPcb
