emorell96/WaterSystemLock/(commit log)

2019-08-12 new files
    [12VSupply.SchDoc, ComparisonSch.SchDoc, ConnectorSch.SchDoc, MainSch.SchDoc, MonitorOut.SchDoc, RTDAnalog.SchDoc, VrefSch.SchDoc, Water System.PrjPcb]
2019-08-21 Added Schematic for Critical Failure Digital Signal Isolation.
    [IsolationOut.SchDoc]
2019-08-21 changed project name for RTD Measurement
    [12VSupply.SchDoc, ComparisonSch.SchDoc, ConnectorSch.SchDoc, IsolationOut.SchDoc, MainSch.SchDoc, MonitorOut.SchDoc, RTDAnalog.SchDoc, RTDMeasurement.PrjPcb]
2019-09-20 Organizing the power delivery into multiple schematics.
    [12VSupply.SchDoc, ComparisonSch.SchDoc, IsolationOut.SchDoc, MonitorOut.SchDoc, Neg5V.SchDoc, PowerDelivery.SchDoc, RTDAnalog.SchDoc, RTDMeasurement.PrjPcb]
2019-09-20 Added numbers to parts, and finished the -5V rail.
    [Neg5V.SchDoc]
2019-09-21 Added 12V Rail using power module. Added separation between AGND and PGND.
    [12VSupply.SchDoc]
2019-09-21 Added NEg 12 V Rail. Needs AGND and PGND to be separated.
    [Neg12V.SchDoc]
2019-09-21 User Saved
    [5VSupply.SchDoc, MainSch.SchDoc, Neg5V.SchDoc, PowerDelivery.SchDoc, VccConnSch.SchDoc]
2019-09-21 added +12V and +5V rail to the power delivery sch.
    [PowerDelivery.SchDoc]
2019-09-23 Separated A Vout from Power V Out. Added Non ERC exception for open emitter with power pin.
    [Neg5V.SchDoc]
2019-09-23 Separated AVOUT from Power VOUT. Added ERC exception to open emitter and power pin on U7.
    [Neg12V.SchDoc]
2019-09-23 Annotated schematic.
    [Neg5V.SchDoc]
2019-09-23 Added power connectors and DIN connector.
    [PowerDelivery.SchDoc]
2019-09-23 changed annotation to avoid naming conflict
    [PowerDelivery.SchDoc]
2019-09-23 Added ports for better inclusion in the hierarhichal structure.
    [5VSupply.SchDoc]
2019-09-23 removed floating power objects
    [5VSupply.SchDoc]
2019-09-23 added pull up for PWRGD: +5 power is working well. 0 Power is not working well.
    [12VSupply.SchDoc]
2019-09-24 Reannotated the whole project for a more organized naming
    [12VSupply.SchDoc, 5VSupply.SchDoc, ComparisonSch.SchDoc, ConnectorSch.SchDoc, IsolationOut.SchDoc, MonitorOut.SchDoc, Neg12V.SchDoc, Neg5V.SchDoc]
2019-09-24 added good connection checks
    [IsolationOut.SchDoc, MainSch.SchDoc, RTDMeasurement.PrjPcb]
2019-09-24 Added isolation to the +5V Rail used for the digital outputs
    [MainSch.SchDoc, PowerIsolation.SchDoc]
2019-09-24 changed INA to +12V - -12V to avoid railing.
    [RTDAnalog.SchDoc]
2019-09-24 PCB design started. Two footprints missing: U6,U8 SOT 563 and J4,J6: CUI SDS 50J SDS 50J
2019-09-24 removed useless din conn
    [5VSupply.SchDoc]
2019-09-24 fixed footprint issue on din conn
    [PowerDelivery.SchDoc]
2019-10-03 added v out pt to -12A
    [Neg12V.SchDoc]
2020-01-31 latest version
    [12VSupply.SchDoc, 5VSupply.SchDoc, Bill of Materials-RTDMeasurement.xls, BufferOut.SchDoc, ComparisonSch.SchDoc, ConnectorSch.SchDoc, IsolationOut.SchDoc, MainSch.SchDoc]
2020-02-13 Most routing complete. Added ground plane.
2020-06-18 init commit
    [12VSupply.SchDoc, 5VSupply.SchDoc, AnalogIsolation.SchDoc, AnalogPressure.SchDoc, Bill of Materials-RTDMeasurement 1.xlsx, Bill of Materials-RTDMeasurement.csv, Bill of Materials-UHV Gate Valve Control.xlsx, BoosterSystem.SchDoc]
2021-01-08 changed power supply to ic switching power supply for better noise performance. And broader range of input power.
    [5VSupply.SchDoc]
2021-01-08 added important fix to neg 12Vsupply. YOu need to short the pin 4 of U8 with Vext for it to work!
    [Neg12V.SchDoc]
2021-01-08 added single on/off switch. Added LEDs to show if the supplies are OK.
    [PowerDelivery.SchDoc]
2021-01-08 removed old power supply and changed it to the new ICs.
    [5VSupply.SchDoc]
2021-01-08 removed unused conn good net. And grounded RTD- in case of unplugged RTD
    [ConnectorSch.SchDoc]
2021-01-08 changed connector to use Flat cable.
    [IsolationOut.SchDoc]
2021-01-08 removed unnecesary parts
    [MainSch.SchDoc]
2021-01-08 Changed output connector to a single flat cable conductor.
    [MonitorOut.SchDoc]
2021-01-09 Added an explicit ERC exception for the NC, DNC pins.
    [VrefSch.SchDoc]
2021-01-09 Removed unnecessary DIN connector.
    [PowerDelivery.SchDoc]
2021-01-09 Added an explicit ERC exception for pin 4 of U8.
    [Neg12V.SchDoc]
2021-01-09 Added an explicit ERC exception for mosfet
    [PowerDelivery.SchDoc]
